afch/NixeTubesShieldNCS314/Firmware/Source code/Hardware Version 3.x (HW3.x)/NCS314_v3_SimpleSample/README.md

# Nixe Tubes Shield NCS314-4 v3.x and NCS314-6 v3.x code Example
Sketch for Arduino UNO/MEGA and Nixie Tubes Shield NCS314 and NCS312 by GRA &amp; AFCH

This very simple code shows the numbers 123456, and then after three seconds changes them to 654321. And so on an infinite number of times.
