afch/NixeTubesShieldNCS314/Firmware/Source code/Hardware Version 2.x (HW2.x)/60MinutesTimer/Readme.txt

Mode button - Start/Pause
Up button - Set to 60 minutes
Down button - Set to 00:00:00

IR Remote controller Sony RM-X151:

"Left" = Up button
"Enter" = Mode button
"Right" = Down button
