afch/NixeTubesShieldNCS314/Schemes/Scheme_Nixie_Clock_Shield_NCS314_v1.2.pdf

Hour | Hour
Min | Min | Sec LAMP1 | LAMP2 | Sec

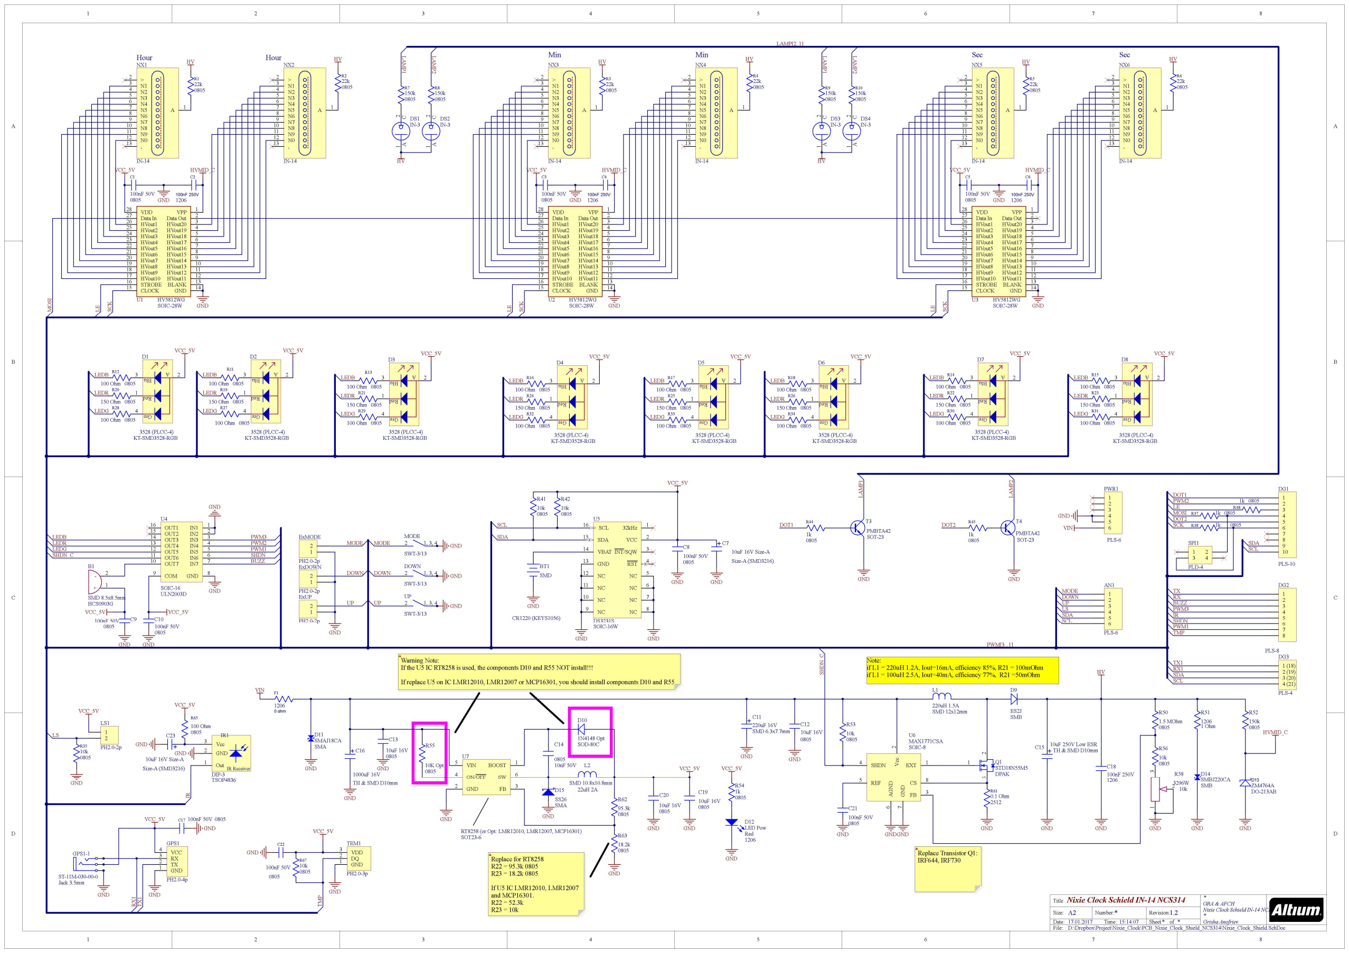
[picture p1: page 1]

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
GRA & AFCH
Nixie Clock Schield IN-14 NCS314 *
* | Grisha Anofriev

## Nixie Clock Schield IN-14 NCS314

* | 1.2
17.01.2017 15:14:07
D:\Dropbox\Project\Nixie_Clock\PCB_Nixie_Clock_Shield_NCS314\Nixie_Clock_Shield.SchDoc

Title

Size: | Number:
Date:
File:

Revision:
Time: | Sheet | of

A2

IN-3 1 2 A CDS2

IN-3 1 2 A CDS1

150k
0805

R8
150k
0805
R7 LAMP1 | LAMP2

LEDR

LEDG

IN-3 1 2 A CDS4

IN-3 1 2 A CDS3

150k
0805

R10
150k
0805

R9

100 Ohm 0805

R12

150 Ohm 0805

R20

100 Ohm 0805

R28

VCC_5V

LEDR

LEDG

100 Ohm 0805

R16

100 Ohm 0805

R32

LEDR

LEDG

100 Ohm 0805

R13

150 Ohm 0805

R21

100 Ohm 0805

R29

LEDR

LEDG

100 Ohm 0805

R18

100 Ohm 0805

R34

LEDR

LEDG

100 Ohm 0805

R17

100 Ohm 0805

R33

LEDR

LEDG

100 Ohm 0805

R15

150 Ohm 0805

R23

100 Ohm 0805

R31

LEDR

LEDG

100 Ohm 0805

R14

150 Ohm 0805

R22

100 Ohm 0805

R30

LEDR

LEDG

LEDB | LEDB LEDB | LEDB | LEDB LEDB LEDB | LEDB
100 Ohm 0805

R11

LED Pow
Red
1206

D12

1k
0805

R54

GND

GND | VCC_5V

95.3k
0805

R62

18.2k
0805

R63

GND

10nF 50V

0805

C14

GND

SS26
SMA

D15

GND

GND

10uF 16V
0805

C13

GND

GND

SOIC-8

SHDN 4

REF 5 | AGND

### 6 GND

7

FB | 3
CS | 8
EXT | 1 Vcc 2

MAX1771CSA

U6 10k
0805

R53

GNDGND

100nF 50V
0805

C21

GND

GND

220uH 1.5A
SMD 12x12mm

L1

ES2J
SMB

D9

100nF 250V
1206

C18

GND | GND

### 1.5 MOhm

0805

R50

10k
0805

R56

GND | GND

10uF 16V
0805

C12

GND

HVMID_C

1206

### 1 Ohm

R51

GND SHDN_C | HV

3296W

10k ³ 1

2

R58

GND

GND

150k
0805

R52

SMBJ220CA
SMB
1000uF 16V | D14
TH & SMD D10mm

C16

10uF 250V Low ESR
TH & SMD D10mm C15

10uF 16V
0805

C20
10uF 16V
0805

C19

10K Opt
0805

R55

SMD 10.8x10.8mm
22uH 2A

L2

1N4148 Opt
SOD-80C

D10

FB | 3
VIN 5 | BOOST | 1

GND 2

SW 6 ON/OFF 4

RT8258 (or Opt: LMR12010, LMR12007, MCP16301) SOT23-6

U7

### Note: if L1 = 220uH 1.2A, Iout=16mA, efficiency 85%, R21 = 100mOhm if L1 = 100uH 2.5A, Iout=40mA, efficiency 77%, R21 =50mOhm

SOIC-16
ULN2003D
IN1 | 1
IN2 | 2
IN3 | 3
IN4 | 4
IN5 | 5
IN6 | 6
IN7 | 7

OUT1 16

OUT3 14
OUT4 13
OUT5 12
OUT6 11
OUT7 10

OUT2 15

COM 9 | GND | 8

U4

SMD

CR1220 (KEYS1056)

BT1

10k
0805

R41
10k
0805

R42

100nF 50V
0805

C8

100nF 50V
0805

C10 100nF 50V
0805

C9

VCC_5V

GND | GND

GND

GND | GND
VCC_5V | VCC_5V

PWM3
PWM2
PWM1
SHDN
BUZZ

SHDN_C

LEDB
LEDR
LEDG

SCL

SDA

10uF 16V Size-A
Size-A (SMD3216)

C7

GND

GND

SMD 8.5x8.5mm
HCS0903G

+

1

2

B1

2 1, 3, 4

SWT-3/13

MODE

2 1, 3, 4

SWT-3/13

DOWN

2 1, 3, 4

SWT-3/13

UP

GND

GND

GND

MODE

DOWN

UP

HV5812WG
SOIC-28W
VPP | 1
Data Out | 2
HVout20 | 3
HVout19 | 4
HVout18 | 5
HVout17 | 6
HVout16 | 7
HVout15 | 8
HVout14 | 9
HVout13 | 10
HVout12 | 11
HVout11 | 12
BLANK | 13
GND | 14 CLOCK 15 | STROBE 16 | HVout10 17 | HVout9 18 | HVout8 19 | HVout7 20 | HVout6 21 | HVout5 22 | HVout4 23 | HVout3 24

VDD 28
Data In 27
HVout1 26
HVout2 25

U1

22k
0805
R1 | 22k
| 0805

R2

100nF 250V
1206

C2

HV | HV

100nF 50V
0805

C1

GND

VCC_5V | HVMID_C

GND

HV5812WG
SOIC-28W
VPP | 1
Data Out | 2
HVout20 | 3
HVout19 | 4
HVout18 | 5
HVout17 | 6
HVout16 | 7
HVout15 | 8
HVout14 | 9
HVout13 | 10
HVout12 | 11
HVout11 | 12
BLANK | 13
GND | 14 CLOCK 15 | STROBE 16 | HVout10 17 | HVout9 18 | HVout8 19 | HVout7 20 | HVout6 21 | HVout5 22 | HVout4 23 | HVout3 24

VDD 28
Data In 27
HVout1 26
HVout2 25

U2

22k
0805
R3 | 22k
| 0805

R4

100nF 250V
1206

C4

HV | HV

100nF 50V
0805

C3

GND

VCC_5V | HVMID_C

GND

HV5812WG
SOIC-28W
VPP | 1
Data Out | 2
HVout20 | 3
HVout19 | 4
HVout18 | 5
HVout17 | 6
HVout16 | 7
HVout15 | 8
HVout14 | 9
HVout13 | 10
HVout12 | 11
HVout11 | 12
BLANK | 13
GND | 14 CLOCK 15 | STROBE 16 | HVout10 17 | HVout9 18 | HVout8 19 | HVout7 20 | HVout6 21 | HVout5 22 | HVout4 23 | HVout3 24

VDD 28
Data In 27
HVout1 26
HVout2 25

U3

22k
0805
R5 | 22k
| 0805

R6

100nF 250V
1206

C6

HV | HV

100nF 50V
0805

C5

GND

VCC_5V | HVMID_C

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
PLS-6

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
PLS-10

DG1

PWM2

MOSI

SCK

MODE
DOWN
UP
LS
SDA
SCL

BUZZ
PWM3

SHDN

VIN

VIN

GND MOSI | LE | SCK
R37 | 1k 0805

PWM1

LE

1k 0805

R48 LE | SCK | LE | SCK
R38 | 1k | 0805

DOT1

1k
0805
R44 | LAMP¹

GND

DOT1
1k
0805
R45 | LAMP²

GND

DOT2

LAMP[2..1]

PWM[3...1]

>

2
N1 3
N2 4
N3 5
N4 6
N5 7
N6 8
N7 9
N8 10
N9 11
N0 12

A

1

,

13

IN-14

NX1

>

2
N1 3
N2 4
N3 5
N4 6
N5 7
N6 8
N7 9
N8 10
N9 11
N0 12

A

1

,

13

IN-14

NX2

>

2
N1 3
N2 4
N3 5
N4 6
N5 7
N6 8
N7 9
N8 10
N9 11
N0 12

A

1

,

13

IN-14

NX3

>

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

A

1

,

13

IN-14

NX4

>

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

A

1

,

13

IN-14

NX5

>

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

A

1

,

13

IN-14

NX6

PLS-6

1
2
3
4
5
6

PWR1

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
PLS-8

DG2

150 Ohm 0805

R26

150 Ohm 0805

R25

150 Ohm 0805

R24
150 Ohm 0805

R19

100 Ohm 0805

R27

SOT-23

PMBTA42

T3

SOT-23

PMBTA42

T4

VCC_5V

100nF 50V
0805

C22

GND | GND

GND

GND

GND

VCC_5V

VCC_5V

10uF 16V Size-A
Size-A (SMD3216)

C23

100 Ohm
0805
R65 RX¹ TX¹ | TMP IR

TX
RX

IR

10k
0805

R67

Out 1

GND 2

Vcc 3

DIP-3
TSOP4836

IR Receiver

IR1

DOT2

VCC_5V

PLD-4

1 2
3 4

SPI1

3528 (PLCC-4)

2

1

KT-SMD3528-RGB

3

4 | Red Blu Gre | A

D1

VCC_5V

3528 (PLCC-4)

2

1

KT-SMD3528-RGB

3

4 | Red Blu Gre | A
D2 | VCC_5V

3528 (PLCC-4)

2

1

KT-SMD3528-RGB

3

4 | Red Blu Gre | A
D3 | VCC_5V

3528 (PLCC-4)

2

1

KT-SMD3528-RGB

3

4 | Red Blu Gre | A

D4

VCC_5V

3528 (PLCC-4)

2

1

KT-SMD3528-RGB

3

4 | Red Blu Gre | A

D5

VCC_5V

3528 (PLCC-4)

2

1

KT-SMD3528-RGB

3

4 | Red Blu Gre | A

D6

VCC_5V

3528 (PLCC-4)

2

1

KT-SMD3528-RGB

3

4 | Red Blu Gre | A

D7

VCC_5V

3528 (PLCC-4)

2

1

KT-SMD3528-RGB

3

4 | Red Blu Gre | A

D8

PH2.0-2p

1

2

ExMODE

PH2.0-2p

1

2

ExUP

PH2.0-2p

1

2

ExDOWN

GND

MODE

DOWN

UP

HV | HV

SCL

SDA

TMP

GND

PH2.0-2p

1
2

LS1

10k
0805

R35

VCC_5V

LS

TX1
RX1
SDA
SCL

1 (18)
2 (19)
3 (20)
4 (21)
PLS-4

DG3

220uF 16V
SMD 6.3x7.7mm

C11

### 0.1 Ohm

2512

R61

STD18N55M5

DPAK ²
1 3

Q1

ZM4764A
DO-213AB

D13

SMAJ18CA
SMA

D11

1206

### 0 ohm

F1

ST-11M-030-00-0
Jack 3.5mm

GPS1-1

GND

GND 1

TX 2

RX 3

VCC 4

PH2.0-4p

GPS1

GND 1

DQ 2

VDD 3

PH2.0-3p

TEM1

32kHz | 1
VCC | 2
INT/SQW | 3
RST | 4 GND 13

VBAT 14

SDA 15

SCL 16

NC | 5
NC | 6
NC | 7
NC | 8 NC 9

NC 10

NC 11

NC 12

DS3231S
SOIC-16W

U5

GND | GND

C17 100nF 50V 0805
GND

### Replace for RT8258

R22 = 95.3k 0805
R23 = 18.2k 0805

### If U5 IC LMR12010, LMR12007

and MCP16301.
R22 = 52.3k
R23 = 10k

### Warning Note: If the U5 IC RT8258 is used, the components D10 and R55 NOT install!!!

If replace U5 on IC LMR12010, LMR12007 or MCP16301, you should install components D10 and R55

### Replace Transistor Q1: IRF644, IRF730
