afch/NixeTubesShieldNCS314/User Manual/1.82/Render_poster_6px_2.png

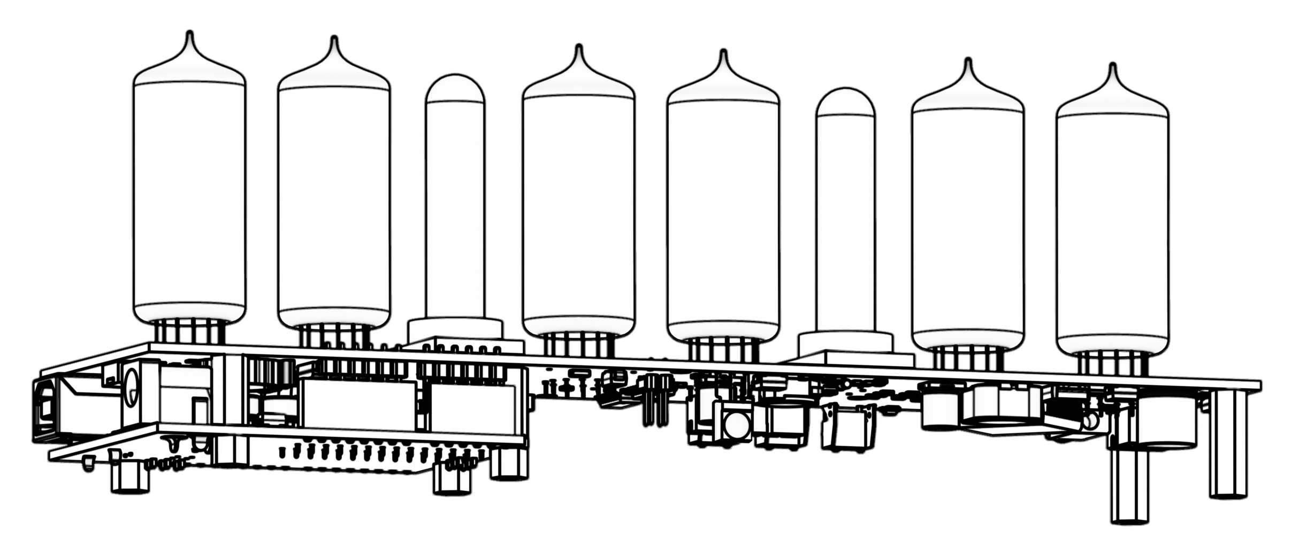
User Manual/1.82/Render_poster_6px_2.png
