afch/NixeTubesShieldNCS314/User Manual/1.82/User Manual Nixie Clock Shield NCS3xx.pdf

# GRA & AFCH

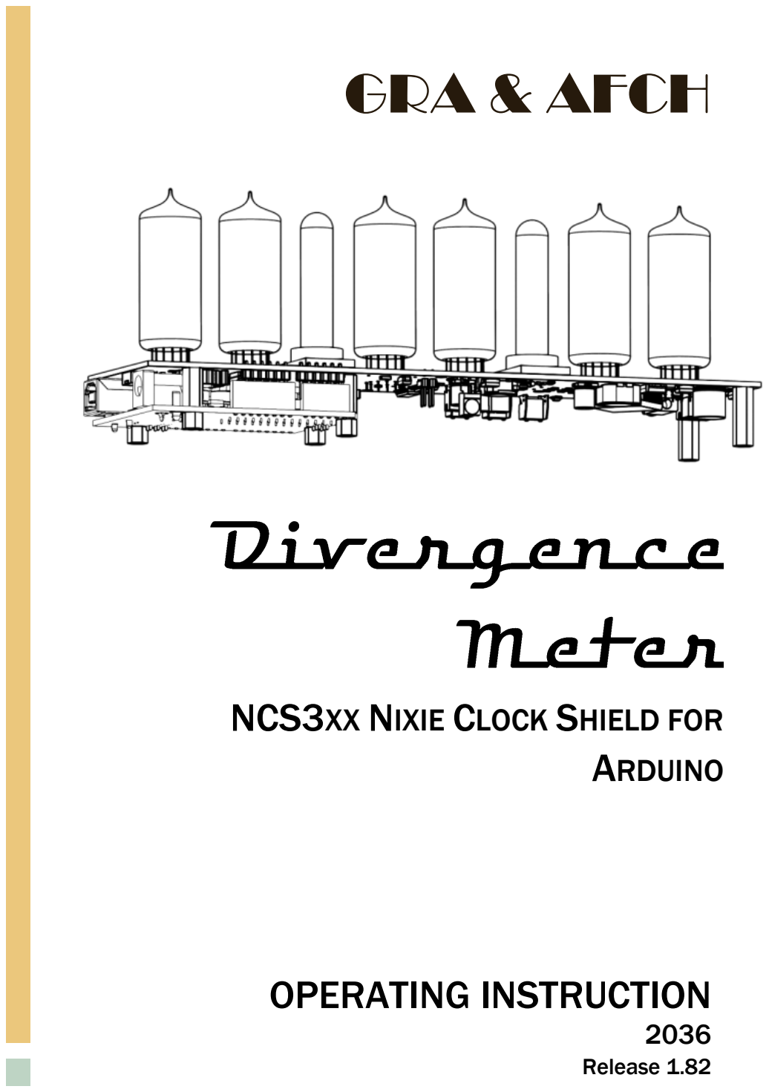
[picture p8: page 1]

# NCS3XX NIXIE CLOCK SHIELD FOR

# ARDUINO

# OPERATING INSTRUCTION

2036

### Release 1.82

GENERAL GU IDE

1. Pr es s “M ode” to ch ang e fr om m ode to m ode . Ea ch m ode is e xpl ain ed in deta il on t he fo ll ow ing pa ges .

TIMEK EEPIN G MODE

T o s e t th e di git al t im e

1. Hol d down “M ode” wh il e in th e Tim e k eepi ng Mo de unt il th e ho ur s digit s s tar t t o flas h . Th e h our s flas h b ec au s e the y are s el ected .
2. Pr es s “Mod e” t o ch ang e th e s el ec ti o n in th e fo ll ow ing s e que nc e:
- Onc e y ou r e ac h th e T im ek e epi ng dis play , y ou ha ve to ho ld d own “ Mo de ” agai n to d is pl ay fl as hi ng h our s .
- Whi le t he d igi ts ar e s el ect ed ( fl as h i ng) , h old d own “ Mo de” t o r e tur n to Tim ek e ep ing M ode w it hou t s av ing .
3. Whi le a ny d igi ts ar e s e le ct ed, pr es s “Up” to i ncr eas e the num ber , or “Down” t o de cr eas e the n um ber . H old ing do wn “Up” or “Dow n” cha nges t h e cur r en t s el ec ti on a t hig h s pee d.
4. After y ou s e t th e tim e , pr es s “M ode” to s e le ct t he T im ek e epi ng M ode .
- If you d o n ot op er at e any bu tt on f or a few m inut es whi le s e le ct io n is flas h ing, the f las h ing s t ops a nd th e cl ock g oes b ack t o th e T im ek e epi ng Mod e aut om at ic al ly.

DATE MODE

T o s e t th e da te

1. Hol d dow n “Mod e” whi le i n the Da te Mod e unt il th e al l dig its s tar t t o flas h .
2. Pr es s “Mod e” t o ch ang e s el ec ti on i n fol low ing s equ en ce:
- Whi le t he d igi ts ar e s el ect ed ( fl as h i ng) , h old d own “ Mo de” t o r e tur n to Tim ek e ep ing M ode w it hou t s av ing .
3. Pr es s “UP” or “Down” butto n to s witc h betw een dd/m m ( 31/ 12 /9 9) for m at an d m m /dd ( 12/ 3 1/9 9) for m at.
4. Whi le a ny d igi ts ar e s e le ct ed, pr es s “Up” to i ncr eas e the num ber , or “Down” t o de cr eas e the n um ber . H old ing do wn “Up” or “Dow n” cha nges t h e cur r en t s el ec ti on a t hig h s pee d.
5. After y ou s e t th e dat e, pr es s “M od e” to s e le ct t he Dat e M ode .
Time | Date | Alarm | 12/24 Time mode
Time Zone* | Temperature
Time | Date | Alarm

Time keeping mode

Days | Months
Date mode | Years

dd/mm or mm/dd
date format

- If yo u do n ot op er at e ant bu tt on f or a few m inutes wh il e a s el ec ti on i s flas h ing, t he fl as hi ng s to ps and c lo ck go es back t o the Da te M od e aut om ati ca ll y.
- The cl o ck d oes m ak e va lid at io n f or c or r ec t da te. S o cl o ck n ot t o r etur n to Date M od e if dat e is i nc or r ec t.

ALARM MODE

Whe n th e Dai ly Alar m Fun cti o n is s wi tch ed on, t he alar m s o unds a t th e pr es et t im e ea ch day. Pr es s an y butt on t o s top th e alar m after i t s tar ts to s ound .

T o s e t th e al ar m tim e

1. Hol d d own “M od e” wh ile in Alar m M o de un ti l th e h our di gits s tar t t o f las h . The h our d igi ts flas h b ec aus e t he y ar e sel ected .
2. Pr es s “Mod e” t o ch ang e s el ec ti on i n the f ol low ing s eq ue nce.
3. Pr es s “Up” or “Down” butto ns to in cr eas e or decr eas e s el ect ed dig its . Hol din g dow n but to ns cha nges the s e lec ti ons a t hig h s pe ed.
4. Dail y alar m on/ off m ode is r epr es e nti ng by upper s epar at e dots , pr es s “Up” or “Down” to e nab le or dis ab le dail y al ar m .
- Enter in g in A la rm Mode a lways sw itc h daily a larm on.
- I f you d o no t o pe rate a ny b ut tons a few m in ut es wh i le a se le ct ion i s flash ing , the f lash ing s to ps and the c loc k g oes t o the T im ek ee pin g Mod e.

12/24 Ho urs Mo de
T o cha nge 12/ 2 4 m od e
1. Enter i n 1 2/ 24 m ode s e tt ings , by h ol ding d own “ Mod e” bu tt on un ti l 1 2 o r 24 d igi ts s tar t t o flas h.
2. Pr es s “Up” or “Dow n” butt ons to s w it ch be twe en 1 2 and 24 m odes .
3. After y ou s et tim e for m at pr es s “Mo de” butt on t o r etur n to Tim ek eep in g m ode.
- I f you d o no t o pe rate a ny b ut tons a few m in ut es wh i le a se le ct ion i s flash ing , the f lash ing s to ps and the c loc k g oe s t o the T im ek ee pin g Mod e

Temperat ure Mode

T o cha nge t em per atur e for m a t Ce ls ius / Fa hr en he it or adjus t s h owi ngs of s e ns or

1. S ele ct T em per a tur e M od e, p r es s ing t he m od e but to n s ev er al t im es . ..
2. Enter in t em per a tur e m od e s ett ings , by ho ldi ng dow n “Mod e” butt on u nti l digi ts s tar t t o fl as h.
3. Pr es s “Up” or “Down” butt ons t o s wit ch bet wee n Cels ius and F ahr e nh ei t for m ats .
4. Pr es s “Mod e” but to n t o s av e s ett ings and r etur n to T em per a tur e m o de.
Hours | Minutes | Seconds
Timekeeping mode | Daily alarm on/off

Celsius / Fahrenheit
Temperature format

Adjustment
of temperature sensor

Temperature
Mode

# web-site: www.gra-afch.com

Time zone*

T o cha nge Time zone fr om -1 2 t o +1 4
1. S ele ct T im e zon e mode , pr es s in g the m ode but to n s ev er al tim es ( defau lt valu e is + 0 2) .
2. Pr es s “Up” to i ncr eas e t he n um ber , o r “Down” t o decr eas e the num ber .
- For n ega tiv e va lu es , th e t op ( or r ig ht ) dots is tur ned off.
3. Pr es s “Mod e” but to n t o s av e s ett ings and r etur n to T im e z one m ode .
* Tim e Z one M od e ava il abl e on ly with Ar d uin o M ega, a nd it is us ed tog eth er wit h an e x t er na l GPS r ecei v er GA-6.

RGB LED Backlight
T o d is ab le LED b ack lig ht
1. Hol d dow n “Dow n” unt il t he LED ba ck ligh t tur ns off.

T o e nab le LED b ack lig ht
1. Hol d dow n “Up” u nt il t he LED ba ck l ig ht tur ns on .

T o f ix c ol or o f LEDs
1. Pr es s “Down” bu tt on .

T o r es um e au tom a ti c LEDs c ol or c han gin g
1. Pr es “Up” butt on .

POWER ON SELF TEST

Im m edi ate ly aft er a cl ock is p ower e d on S elf- Tes t is s tar t ing in t he fo ll o wing s eque nc e:

1. Red LEDs o n.
2. Gr een LEDs on.
3. Blu e LEDs o n.
4. Tubes t es t w hi ch dis pla y al l dig its fr o m 0 to 9 on a ll tub es s im ul tan eo us ly .
5. Fir m war e ver s i on .
6. S ound t es t.
