afch/NixeTubesShieldNCS314/User Manual/1.82/[Originals]/Render_WO_IR_White_6px.JPG

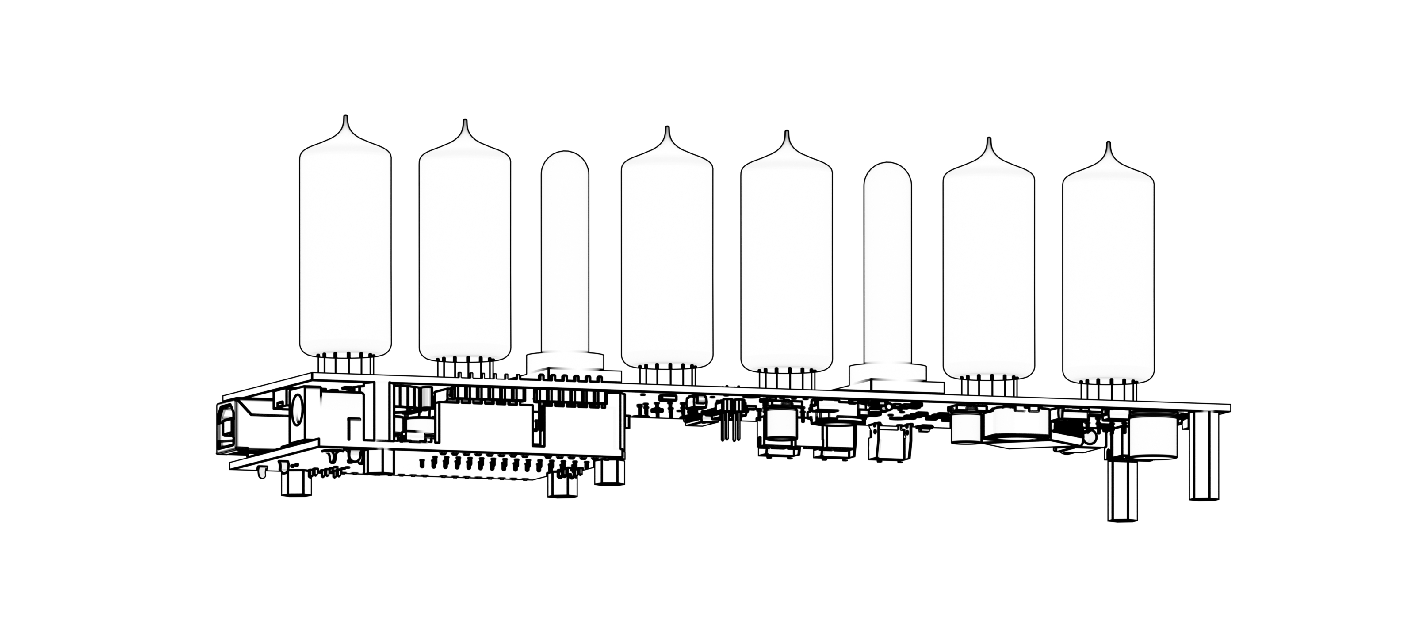
User Manual/1.82/[Originals]/Render_WO_IR_White_6px.JPG
