afch/NixeTubesShieldNCS314/User Manual/1.82/Render_White_6px.JPG

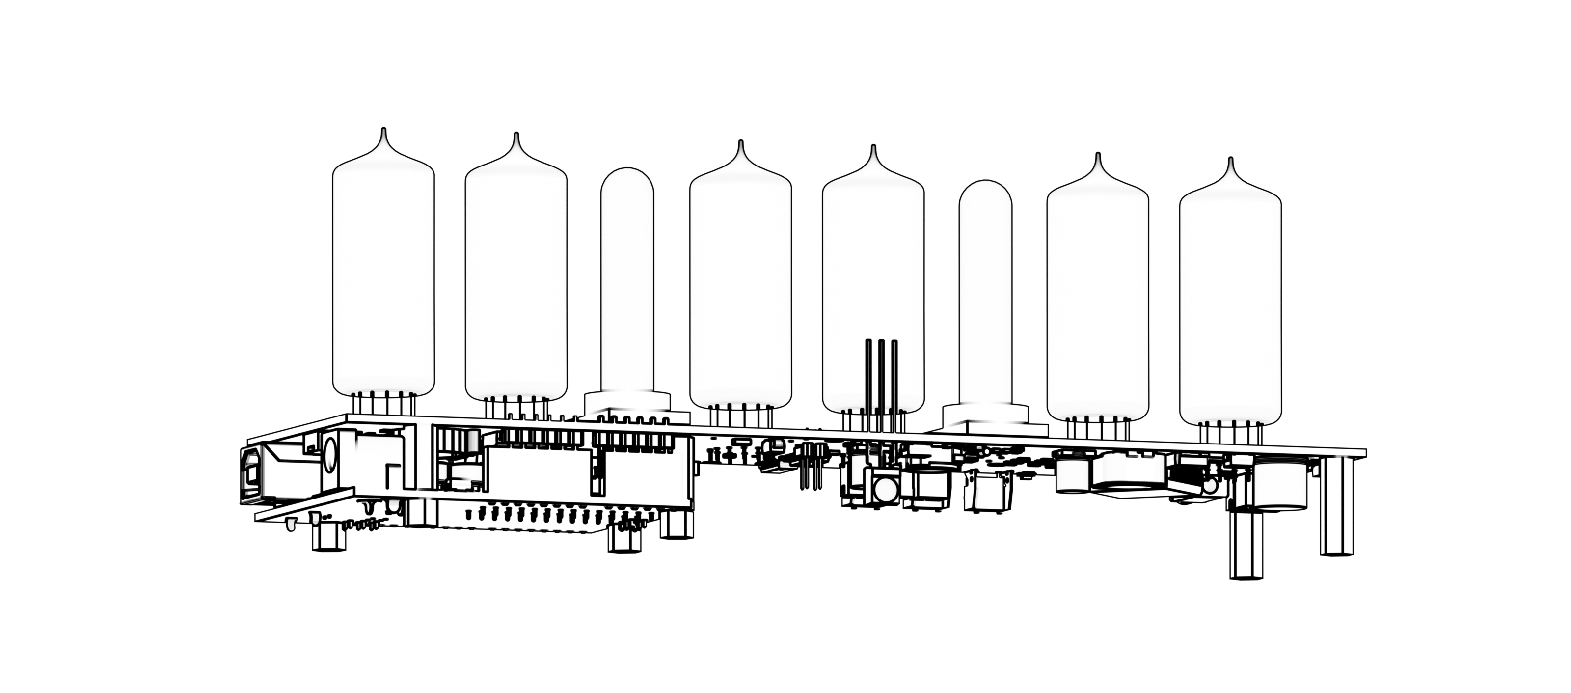
User Manual/1.82/Render_White_6px.JPG
