afch/NixeTubesShieldNCS314/(threads)

Thread 3 (2017-11-19):

Any plans to support Serial Slave Operation?

gilgameshskytrooper, 2017-11-19:
So I know currently you guys don't support Slave via Serial USB, but do you have any plans to add this in the future? ([like this](https://github.com/afch/Slave-Nixie-Clock)

afch, 2017-11-20:
We did not plan to do this in the near future.
But we are sure that it will not be difficult at all to transfer this functional from the old version.
In addition, we have an experimental adapter for connecting our watches to the RaspberryPI.
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

gubagu, 2017-11-21:
Why not to esp8266 instead of raspberry? RPI is such an overkill for a clock. Though it could be a bit of a hassle if you the project uses a low to pwm pins. esp8266 has only one analog pin ...

gilgameshskytrooper, 2017-11-21:
True, but essentially in already using a Pi for the alarm functionality for [my project](https://hackaday.io/project/15048-prometheus-alarm-clock). So I thought I might as well try to utilize NTP to control the nixie displays as well.

Thread 6 (2018-02-17):

Troubleshooting guide?

rcreasey, 2018-02-17:
I just got done with a marathon of soldering only to plug it in and not have any response from the shield.

Are there typical things to check or debug?

afch, 2018-02-21:
Typical problem is in power adapter.
Check voltage at test points:
TP1 - must be 12-15 Volts
TP3 - must be 5 Volts
TP4 - must be 170-190 Volts

2018-02-17 23:34 GMT+02:00 Ryan C. Creasey <notifications@github.com>:

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

--
Alexey [GRA & AFCH]

rcreasey, 2018-02-21:
Ah, you're right.  The voltage is low on those touch points.  Is the USB power draw on the arduino mega not sufficient to power the shield?  Will I need the power adapter for the mega?

afch, 2018-02-21:
Yes, it will work only with external power adapter 12-15 Volts, 1 (or more)
Ampere.

21 февр. 2018 г. 6:42 ПП пользователь "Ryan C. Creasey" <
notifications@github.com> написал:

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

rcreasey, 2018-02-24:
Hrm, I've got a 12V/1A power adapter and I'm seeing the following:

TP1 - 2v
TP3 - 2.1v
TP4 - 2.1v

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

rcreasey, 2018-02-25:
I should also note that I'm able to see the serial logs for the display test and on the first bootup with re-flashing the .ino, I did "hear" the musical theme play (albeit very quietly).

Subsequent unplugs have not re-prompted the musical tune however.

Serial logs show that the menu buttons are indeed working.

afch, 2018-03-01:
Sorry for delay with answer.
With good quality 12 Volts adapter, you must get about 11.2 Volts on TP1!!!
I think than You need to replace your adapter.

2018-02-25 2:25 GMT+02:00 Ryan C. Creasey <notifications@github.com>:

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

--
Alexey [GRA & AFCH]

Thread 7 (2018-02-28):

LS1 Connector

edgarasf123, 2018-02-28:
Is there a reason for LS1 connector? I noticed its connected to A3(analog input) but its not being used in any way within the firmware.

afch, 2018-03-01:
Now it is not used at all, we planned to connect an ambient light sensor,
but changed our minds.

2018-02-28 12:42 GMT+02:00 H3xCat <notifications@github.com>:

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

--
Alexey [GRA & AFCH]

edgarasf123, 2018-03-01:
I see, thank you for response.

judge2005, 2018-03-02:
I forked the repo a while back and implemented dimming using an LDR, plus a bunch of other stuff such as cross-fading, date display, date formats, etc. Plus control via an ESP01 connected as an I2C master. Code is in https://github.com/judge2005/NixeTubesShieldNCS314, specifically https://github.com/judge2005/NixeTubesShieldNCS314/blob/master/NixieClockShieldNCS314HW1.1.ino.

Code for ESP01 is in https://github.com/judge2005/NCS314WiFi

edgarasf123, 2018-03-17:
I'm in the process of creating my own firmware, though its only for HW2.0 cause that is what I got. So far I was able to write GPS support(auto baud detection), DST, and Nixie library. It currently only shows time retrieved from GPS, so without GPS it won't show anything. I'm going to be implementing RTC next.

https://github.com/edgarasf123/NixieClockFW

Closed 2018-03-01.

Thread 9 (2018-04-06):

Red LED color doesn't save on shutdown

wiilover22, 2018-04-06:
Simple little bug, with hopefully a quick fix. When you turn off the clock (by unplugging it or otherwise), if the last color used is red, it'l start back up on a blue/purple color next startup.

afch, 2018-04-09:
Thank you, you really found a bug...

2018-04-07 1:33 GMT+03:00 wiilover22 <notifications@github.com>:

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

--
Alexey [GRA & AFCH]

afch, 2018-12-13:
Fixed

Closed 2018-12-13.

Thread 12 (2018-10-31):

error

stilloading, 2018-10-31:
i get this
avrdude.exe: stk500_recv(): programmer is not responding
avrdude.exe: stk500_getsync() attempt 1 of 10: not in sync: resp=0xa4
avrdude.exe: stk500_recv(): programmer is not responding
avrdude.exe: stk500_getsync() attempt 2 of 10: not in sync: resp=0xa4
avrdude.exe: stk500_recv(): programmer is not responding
avrdude.exe: stk500_getsync() attempt 3 of 10: not in sync: resp=0xa4
avrdude.exe: stk500_recv(): programmer is not responding
avrdude.exe: stk500_getsync() attempt 4 of 10: not in sync: resp=0xa4
avrdude.exe: stk500_recv(): programmer is not responding
avrdude.exe: stk500_getsync() attempt 5 of 10: not in sync: resp=0xa4
avrdude.exe: stk500_recv(): programmer is not responding
avrdude.exe: stk500_getsync() attempt 6 of 10: not in sync: resp=0xa4
avrdude.exe: stk500_recv(): programmer is not responding
avrdude.exe: stk500_getsync() attempt 7 of 10: not in sync: resp=0xa4
avrdude.exe: stk500_recv(): programmer is not responding
avrdude.exe: stk500_getsync() attempt 8 of 10: not in sync: resp=0xa4
avrdude.exe: stk500_recv(): programmer is not responding
avrdude.exe: stk500_getsync() attempt 9 of 10: not in sync: resp=0xa4
avrdude.exe: stk500_recv(): programmer is not responding
avrdude.exe: stk500_getsync() attempt 10 of 10: not in sync: resp=0xa4

avrdude.exe done.  Thank you.

what to do ?
i am using arduino uno,

stilloading, 2018-11-01:
i only have one port to chose from, and i have this arduino
https://www.ebay.com/itm/263884202082
does the other type of arduino work differently ?

afch, 2018-11-06:
> i only have one port to chose from, and i have this arduino
> https://www.ebay.com/itm/263884202082
> and on the internet it says there is no difference in this arduino borad compared to others.
try to install this driver: https://gra-afch.com/drivers/CH340g_Windows_Drivers.zip

stilloading, 2018-11-06:
i still get same problem
avrdude: Version 6.3-20171130
         Copyright (c) 2000-2005 Brian Dean, http://www.bdmicro.com/
         Copyright (c) 2007-2014 Joerg Wunsch

         System wide configuration file is "C:\Program Files (x86)\Arduino\hardware\tools\avr/etc/avrdude.conf"

         Using Port                    : COM3
         Using Programmer              : arduino
         Overriding Baud Rate          : 115200
avrdude: stk500_recv(): programmer is not responding
avrdude: stk500_getsync() attempt 1 of 10: not in sync: resp=0x6c
avrdude: stk500_recv(): programmer is not responding
avrdude: stk500_getsync() attempt 2 of 10: not in sync: resp=0x6c
avrdude: stk500_recv(): programmer is not responding
avrdude: stk500_getsync() attempt 3 of 10: not in sync: resp=0x6c
avrdude: stk500_recv(): programmer is not responding
avrdude: stk500_getsync() attempt 4 of 10: not in sync: resp=0x6c
avrdude: stk500_recv(): programmer is not responding
avrdude: stk500_getsync() attempt 5 of 10: not in sync: resp=0x6c
avrdude: stk500_recv(): programmer is not responding
avrdude: stk500_getsync() attempt 6 of 10: not in sync: resp=0x6c
avrdude: stk500_recv(): programmer is not responding
avrdude: stk500_getsync() attempt 7 of 10: not in sync: resp=0x6c
avrdude: stk500_recv(): programmer is not responding
avrdude: stk500_getsync() attempt 8 of 10: not in sync: resp=0x6c
avrdude: stk500_recv(): programmer is not responding
avrdude: stk500_getsync() attempt 9 of 10: not in sync: resp=0x6c
avrdude: stk500_recv(): programmer is not responding
avrdude: stk500_getsync() attempt 10 of 10: not in sync: resp=0x6c

avrdude done.  Thank you.

Problem uploading to board.  See http://www.arduino.cc/en/Guide/Troubleshooting#upload for suggestions.

stilloading, 2018-11-25:
i foubd out its the firmware on the arduino that is faulty because it is cheap, i fixed it by following this video
https://www.youtube.com/watch?v=90GZ7WhvubM
But now i have the problem that it suddenly stops and plasshes as seen here in the end of the video (i also had problems with the RGB LED,s but that was just bad soldering on my part)
https://www.youtube.com/watch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

Thread 13 (2018-12-12):

HW2.2 scheme missing

Adrian-at-CrimsonAuzre, 2018-12-12:
Like the title says, circuit diagrams are missing for the new version of the clock.

Would it be possible to upload the 3D models of the clocks as well? It would be nice to have to design 3D printed cases for the clock.

edgarasf123, 2018-12-12:
I thought the circuit is basically the same as HW2.0, except it comes with sockets.

edgarasf123, 2018-12-12:
Regarding 3D models, cases specifically, I asked the authors if they could provide the files for laser cutting ourselfs. They said they didn't have access to those files, since third-party is manufacturing the cases.

Regardless, I managed to replicate the case in Fusion 360 and laser cut them. I got the buttons a bit off though, used Dremel to fix it.
https://a360.co/2C6ZKcT

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

afch, 2018-12-13:
Scheme v2.2. now available on github:
https://github.com/afch/NixeTubesShieldNCS314/blob/master/Schemes/Scheme_Nixie_Clock_Shield_NCS314_v2.2.pdf

ср, 12 дек. 2018 г. в 07:59, H3xCat <notifications@github.com>:

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

--
Alexey [GRA & AFCH]

Closed 2018-12-13.

Thread 14 (2019-02-13):

how to deactivate slot machine effect

Gauner101184, 2019-02-13:
Hi,

i want to deactivate slot machine effect and showing date.
Which lines i have to change in source code for disabling these features?
I only want to show actual time without any effects.

edgarasf123, 2019-02-14:
I wouldn't recommend this, as it would drastically decrease the lifetime of your nixie tubes.

afch, 2019-02-14:
If You still want this, You need to find and comment the string like this:
if ((menuPosition == TimeIndex) || (modeChangedByUser == false) ) modesChanger();

Gauner101184, 2019-02-15:
> If You still want this, You need to find and comment the string like this:
> if ((menuPosition == TimeIndex) || (modeChangedByUser == false) ) modesChanger();

Thanks for your answer.
But that's the actual code.
What i have to change?

z0ne123, 2020-01-13:
> If You still want this, You need to find and comment the string like this:
> if ((menuPosition == TimeIndex) || (modeChangedByUser == false) ) modesChanger();

Is it also possible to leave in the slotmachine effect for anti-poisoning and disable everything else. So the clock only displays time and every once in a while does a slotmachine effect. Thanks

afch, 2020-01-14:
Yes, it is possible.
You can have only SlotMachine without Date and Temp display.

пн, 13 янв. 2020 г. в 16:07, z0ne123 <notifications@github.com>:

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

--
Alexey [GRA & AFCH]

z0ne123, 2020-01-14:
> Yes, it is possible.

Can you elaborate how? I can't figure out how to do it in the regular settings, I have some basic programming skills, but I don't know what edits I have to do to get this to work!

I commented this line at the moment :
// if ((menuPosition == TimeIndex) || (modeChangedByUser == false) ) modesChanger();

But this disables all except the time, slotmachine is disabled as well now.

afch, 2020-01-16:
Hello.

Please use attached screenshot from Debug window as reference.
Comment highlighted portions as shown.
And add line of code that is underlined at bottom of screenshot.
That should omit the showing of date and temperature readings from
SlotMachine routine.

If there will be questions, feel free to ask.
Regards.

вт, 14 янв. 2020 г. в 14:34, z0ne123 <notifications@github.com>:

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

--
Alexey [GRA & AFCH]

Thread 17 (2020-10-07):

Is it possible to turn the bulbs off in software?

SapientHetero, 2020-10-07:
I'd like to integrate a PIR sensor with a NCS314 V2.2 in order to extend bulb life by turning them off when nobody is in the room to see them. Is there any way to do this in software?

afch, 2020-10-08:
Hello.

We have a Hardware pinout and logic on the Board for the PIR sensor.
However we did not implemented its usage in the Software (Firmware).
One of our buyers have implemented several similar functions in our
Firmware as a mods.
Please use link below to his blog and ask him for code and other info:
https://www.buildxyz.xyz/nixieclock-build-guide/

This blog should be useful to you.
Write back if there will be any other questions.

Regards.

ср, 7 окт. 2020 г. в 17:30, Sapient Hetero <notifications@github.com>:

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

--
Alexey [GRA & AFCH]

h3xcat, 2020-10-09:
https://github.com/afch/NixeTubesShieldNCS314/blob/master/Firmware/Source%20code/Hardware%20Version%202.0%20(HW2.0)/NixieClockShield_NCS314/doIndication314_HW2.x.ino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

https://github.com/afch/NixeTubesShieldNCS314/blob/master/Firmware/Source%20code/Hardware%20Version%202.0%20(HW2.0)/NixieClockShield_NCS314/doIndication314_HW2.x.ino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

Delorean14, 2021-01-21:
https://github.com/afch/NixeTubesShieldNCS314/blob/adb9bca8aa63063cb1de16f8eab42e1fc1e984dd/Firmware/Source%20code/Hardware%20Version%202.0%20(HW2.0)/NixieClockShiel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

Write this variable LOW and they shut off.

regorwislon, 2023-02-21:
Can you shed more light (information) on the logic / pinout for a PIR sensor on the NCS314 board (I have v3.4) that you refer to.  I note from the board schematic that pin D8 is not used by the shield and potentially could be used to connect a PIR sensor. I was thinking of using this to set BL (SHDN) on pin D5 “LOW” when the sensor did not detect any motion for a period, which would turn off the high voltage to all of the tubes, but there is probably a more elegant way of accomplishing this. The link you suggested to another customer didn’t really help me with this as much as I had hoped.

SapientHetero, 2023-02-21:
I ended up switching from the PIR sensor to an ultrasonic sensor: https://www.amazon.com/HiLetgo-HC-SR04-Ultrasonic-Distance-MEGA2560/dp/B00E87VXH0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 because the PIR sensor kept detecting the airflow from air conditioning vents in the ceiling and no filter algorithm I tried could reject it well enough while still sensing human presence. These aren’t perfect either but they’re better than the PIR sensors.

```
// Proximity Sensor – note that it also needs power and ground
#define TRIGGER_PIN  23   // Arduino pin tied to trigger pin on the ultrasonic sensor.
#define ECHO_PIN     25   // Arduino pin tied to echo pin on the ultrasonic sensor.
NewPing sonar(TRIGGER_PIN, ECHO_PIN, MAX_DISTANCE); // NewPing setup of pins and maximum distance.
```

Here's the code I use with the sensor

`// ***** Handle Peeking - detect/extend/end peek mode

  // Starting peek mode in response to ultrasonic sensor
  // If object is detected within configured distance while bulbs are off (sleeping), turn bulbs on in dimmed mode (set elsewhere) for the configured period of time.
  // If daytime, leave them on as long as object is detected
  if (sleeping) {

    if (Settings.alarmBulbsOnDuration && alarmRinging) {               // if configured to do so...
      if (!peekStart)                                                  //  and not already peeking...
        peekStart = millis();                                          //  enter Peek mode on alarm...
      peekDuration = Settings.alarmBulbsOnDuration;                    //  for the configured period of time.
      sleeping = false;                                                //  turn sleeping off when alarm sounds so bulbs turn on
      dimming = false;                                                 //  turn off dimming so PWM doesn't distort alarm music
      RGBLedsOn = Settings.RGBLedsOn;                                  //  and restore RGB LEDs to previous setting
      //DEBUG_PRINTLN(F("Entering peek mode due to alarm"));
    }

    // while waiting for peeking to end, just disable sleeping
    if (peekStart > 0 && (millis() - peekStart < (uint32_t)peekDuration * 1000UL)) { // leave bulbs on if in peek mode...
      sleeping = false;
    }

    // check for sonar ping indicating peeking should start or be extended
    if (millis() - lastSonarPingTime > SONAR_READ_INTERVAL &&                // only do pings at specified interval...
        !ESPTransactionInProgress) {                                         //  and NOT when a transaction is in progress or Serial3 data will be lost
      lastSonarPingTime = millis();                                          // don't ping too often or processor becomes sluggish
      uint16_t maxDistance = (uint16_t)Settings.dayPeekDistance;             // if not dimming, activate sonar at max distance
      if (dimming)                                                           // at night, activate only when sensor is triggered at configured distance
        maxDistance = Settings.peekDistance;
      if (alarmRinging)
        maxDistance = Settings.peekDistance;                        // if alarm is ringing, turn it off if hand is waved in front of sensor
      maxDistance = maxDistance*2 + maxDistance/2;                           // convert maxDistance to cm from inches, roughly
      uint32_t distance = sonar.ping_in(maxDistance);                        // do a ping
      if (distance > 0 && distance <= maxDistance) {                         // if distance is zero, there was no detection, otherwise...
        if (alarmRinging) {                                                  //  if alarm is ringing...
          alarmRinging = false;                                              //   turn it off...
          song = parseSong(noSong);                                          //   and stop playing song
        } else if (!peekStart)
          peekDuration = Settings.peekDuration;                              // determines how long peek will last
        peekStart = millis();                                                // indicates peek cycle in progress and tells us when to end it if it's night time
        sleeping = false;                                                    // turn off sleeping so time is displayed
      }
    }
  }

  // ending peek mode
  if (peekStart > 0) {
    if (millis() - peekStart > (uint32_t)peekDuration * 1000UL) {            // turn peek mode off after configured time elapses
      DEBUG_PRINTLN(F("Leaving peek mode"));
      peekStart = 0;
    }
  }

`

regorwislon, 2023-02-22:
Thank you. I'll try and get my head around that. I still haven't figured out the best way to actually turn the tubes off / on.

regorwislon, 2023-02-22:
I'm thinking of using LEpin as suggested above, and only allowing it to go HIGH if recent motion has been detected. Is that too simple?

regorwislon, 2023-02-22:
It was too simple! Setting LEpin LOW only stops the tubes from changing from what they are already displaying. However my original idea of using BL (the Blanking pin) by setting pinSHDN  LOW does turn them off, and restoring pinSHDN to HIGH turns them back on again. 🙂

SapientHetero, 2023-02-22:
Glad you got it working.

You can also dim the bulbs by using pulse width modulation on LEpin.

// these values determine how dim the bulbs are when dimming is enabled. Lower pulse width + lower delay = dimmer bulbs

uint8_t dimPulseWidth[4] = {15, 30, 45, 65};

uint32_t dimDelay[4] = {500, 1000, 1500, 2000}; // in microseconds; this matters more than pulsewidth

Then insteading of setting LEpin high to display the time, set it to your desired pulse width

if (dimming) {

delayMicroseconds(dimDelay[Settings.dimmingSetting-1]);

analogWrite(LEpin, dimPulseWidth[Settings.dimmingSetting-1]);

}

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

regorwislon, 2023-02-22:
Many thanks for your help and for sharing your knowledge and work. much appreciated.

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

SapientHetero, 2023-02-23:
By the way,  I am using a combination Mega/ESP8266 board to control my Nixie Clock [[https://www.amazon.com/gp/product/B07THDDFSJ/ref=ppx_yo_dt_b_search_asin_title?ie=UTF8&psc=1](url). Instead of using the non-user-friendly buttons on the back of the clock to change settings, I run a webserver on the ESP8266 and control it via WiFi.

regorwislon, 2023-02-23:
Nice idea. I have played around with the ESP32Cam board which also runs a webserver to monitor the camera so I might explore this combined board when I have a bit of time. Still have to build a case for my clock.

Thread 18 (2020-11-13):

Option > blinking, static or off columns/colons in time mode?

Gittegatt, 2020-11-13:
Hello afch,
I like the clock very much. I would really appreciate it, if you could add the option to deactivate still blinking columns/colons in time mode to have the choice about blinking, static or off columns/colons. If you don't like and reject the proposal, could anyone please let me know how to change the code to get static or off columns/colons? Or would you do not recommend to fire the columns/colons bulbs all the time in general?

Regards,
Gittegatt.

afch, 2020-11-16:
Hello Gittegatt.

We do not recommend in general to turn ON the Columns for all the time.
However there is a possibility to turn OFF the Dots by changing the code in
the Firmware.
If you will be able to change the code in the Firmware we can provide the
code segment for you.
Please write back to us.

Regards.

пт, 13 нояб. 2020 г. в 19:44, Gittegatt <notifications@github.com>:

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

--
Alexey [GRA & AFCH]

Gittegatt, 2020-11-18:
Hello afch,
yes - provisioning of the part of code in time mode would be great! Thanks.

Regards.

Gittegatt, 2021-02-03:
Any ideas?

Regards.

h3xcat, 2021-02-04:
You can try modifying my firmware which should be a bit easier. Though my firmware was written NCS314 HW2.0 specifically and can't guarantee compatibility with any other hardware versions.

In your case, you can omit the following block and it would turn the columns into static.
https://github.com/h3xcat/nixie-clock-fw/blob/master/NixieClockFW/NixieClockFW.ino#L104-L109

Closed 2023-05-24.

Thread 19 (2020-11-17):

IR Remote No longer Working on Firmware Version 1.9

SlashWade, 2020-11-17:
Hi, I upgraded the firmware to version 1.9 and the IR Remote is no longer working. Is anyone else having this issue?

afch, 2020-11-17:
Hello Asad.

Please provide the version of your Shield Board.
And also the Firmware version for us.
And we will be able to provide help.

Regards.

вт, 17 нояб. 2020 г. в 02:36, Asad <notifications@github.com>:

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

--
Alexey [GRA & AFCH]

SlashWade, 2020-11-17:
Thank you, I have the NCS314 V2.2, previously used Firmware version 1.86 and everything worked but now I'm using 1.9 with minor modifications shown here: https://github.com/SlashWade/nixie/tree/testingSIlence.

Did I mess up the code?

afch, 2020-11-18:
Hello Asad.

It seems like you could have used the file for another Shield Board version.
Please double check the file again, it should be for the Board ver 2.2, not
for 3.4.
Write back if you will need help.

Regards.

вт, 17 нояб. 2020 г. в 21:19, Asad <notifications@github.com>:

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

--
Alexey [GRA & AFCH]

SlashWade, 2020-12-05:
Hi, yes the firmware is for the correct board version. I uploaded your original 1.90 firmware (https://github.com/afch/NixeTubesShieldNCS314/tree/master/Firmware/Source%20code/Hardware%20Version%202.0%20(HW2.0)/NixieClockShield_NCS314) and the IR still did not work.

I only made minor changes to this file (https://github.com/SlashWade/nixie/blob/testingSIlence/NixieClockShield_NCS314/NixieClockShield_NCS314.ino) and the IR stopped working.

The old version 1.86 firmware used to work perfectly, can I have a link to that? Thanks.

GRA-AFCH, 2020-12-07:
Hello Asad.

The previous Firmware version is available on our GitHub channel: 'afch'.
Feel free to use it, meanwhile we will look into the issue and check the
latest Firmware for issues regarding the Remote.

Regards.

вс, 6 дек. 2020 г., 01:47 Asad <notifications@github.com>:

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

Thread 21 (2021-01-16):

Slot machine effect does not work correctly with connected temperature sensor

Uhwah, 2021-01-16:
My Clock is a NCS314-6 v3.3
When I connected the temperature sensor, the slot machine effect does not work properly.  The display sometimes jumps to the next value and back again before the slot machine effect is over.  It doesn't look very nice optically.  Tested with Arduino UNO and Mega.  as soon as I remove the sensor everything works fine.

If you are interested, I can provide a video.

Thread 23 (2021-04-01):

IR not working for UNO or MEGA 1.94

bobsalt, 2021-04-01:
I can't get IR receiver to work. I've tried compiled hex and ino compile, on UNO and MEGA boards.
I see where someone had same issue, and said the 1.86 version works, but I can't find that version anywhere.

any update on this?

edit:
using remote that works on older in-12 clock (assuming same remote IR codes?)
Firmware version: 1.940
NCS314 for HW 2.x

bobsalt, 2021-04-06:
It was the remote, I found a rm-x153 and can get mode, up and down to work with it.
The power doesn't do anything though and that was my goal.
sorry and thanks!
bobsalt

afch, 2021-04-06:
Hello.

Great, if you will need more help, feel free to write back.

Regards.

вт, 6 апр. 2021 г. в 03:08, bobsalt ***@***.***>:

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

--
Alexey [GRA & AFCH]

Closed 2021-04-06.

Thread 24 (2021-04-15):

Firmware for NCS312 v1.5?

zen85, 2021-04-15:
Hello!

I just got the NCS312 v1.5 and i tried severall firmwares for it since there is none dedicated to v1.5. But they show the wrong values. I tried with a mega and with an uno. the behaviour is the same. iE when i use the following code:
`
//NIXIE CLOCK SHIELD NCS314 v 2.x by GRA & AFCH (fominalec@gmail.com)
//1 26.06.2018
//Simple code for HV5122PJ-G Hihg Voltage registers

#include <SPI.h>

const byte LEpin=10; //pin Latch Enabled data accepted while HI level

String stringToDisplay="000000";// Conten of this string will be displayed on tubes (must be 6 chars length)

//                            0      1      2      3      4      5      6      7      8       9
unsigned int SymbolArray[10]={1,     2,     4,     8,     16,    32,    64,    128,   256,    512};

/*******************************************************************************************************
Init Programm
*******************************************************************************************************/
void setup()
{

  Serial.begin(115200);
  Serial.println(F("Starting"));

  pinMode(LEpin, OUTPUT);

 // SPI setup
  SPI.begin(); //
  SPI.setDataMode (SPI_MODE2); // Mode 2 SPI
  SPI.setClockDivider(SPI_CLOCK_DIV8); // SCK = 16MHz/8= 2MHz

}

/***************************************************************************************************************
MAIN Programm
***************************************************************************************************************/
void loop() {
  stringToDisplay="123456";
  Serial.println(stringToDisplay);
  doIndication();
  delay(3000);
  stringToDisplay="222222";
  Serial.println(stringToDisplay);
  doIndication();
  delay(3000);
}

void doIndication()
{
  digitalWrite(LEpin, LOW);    // allow data input (Transparent mode)
  unsigned long Var32=0;

  long digits=stringToDisplay.toInt();

  //-------- REG 1 -----------------------------------------------
  Var32=0;

  Var32|=(unsigned long)(SymbolArray[digits%10])<<20; // s2
  digits=digits/10;

  Var32|=(unsigned long)(SymbolArray[digits%10])<<10; //s1
  digits=digits/10;

  Var32|=(unsigned long) (SymbolArray[digits%10]); //m2
  digits=digits/10;

  SPI.transfer(Var32>>24);
  SPI.transfer(Var32>>16);
  SPI.transfer(Var32>>8);
  SPI.transfer(Var32);

  //digitalWrite(LEpin, LOW);
 //-------------------------------------------------------------------------

 //-------- REG 0 -----------------------------------------------
  Var32=0;

  Var32|=(unsigned long)(SymbolArray[digits%10])<<20; // m1
  digits=digits/10;

  Var32|= (unsigned long)(SymbolArray[digits%10])<<10; //h2
  digits=digits/10;

  Var32|= (unsigned long)SymbolArray[digits%10]; //h1
  digits=digits/10;

  //digitalWrite(LEpin, HIGH);

  SPI.transfer(Var32>>24);
  SPI.transfer(Var32>>16);
  SPI.transfer(Var32>>8);
  SPI.transfer(Var32);

  digitalWrite(LEpin, HIGH);     // latching data
}

`

i get "999999" instead of "222222" and "89._t567" instead of "123456"

which firmware should i use?

esegege, 2021-06-04:
Hi, I have the same problem, do you solve it?

sdonogh, 2021-08-05:
I have the same issue

esegege, 2021-08-05:
I didnt found firmware for v 1.5, the developer said that the Firmware for this Model have merged with the NCS314 Repository.

grnbrg, 2021-12-02:
I received an NCS312 v1.5 (14/08/2020) pre-built shield today.  I was able to compile and flash an Arduino Mega with firmware based on the source at `NixeTubesShieldNCS314/Firmware/Source code/Hardware Version 2.0 (HW2.0)/`.

So it is possible.  I haven't had much of a chance to do much testing, but it appears to work as expected.  My only (minor) issue is that the buzzer is much louder than I'd like.  Hopefully I can find some way to make it quieter in software, or I may have to just desolder it from the board....

h3xcat, 2021-12-02:
Not all firmwares are compatible, as there are some that use different pin assignments and chip components. Schematics for NCS312V1 and NCS314V2 do appear to be identical. As long as they use the same pin assignments and components, I don't see any issues with swapping the firmware.

https://gra-afch.com/category/downloads/schemes/shields/

I found these schematics quite useful for converting my own custom firmware to NCS318 from NCS314.

grnbrg, 2021-12-02:
Yes, I spent a fair amount of time reviewing the schematics and examining the board before settling on the 314v2.0 source.  In the newer hardware versions, the two main tube drivers have been consolidated into a single large chip, so the 3.x tree was a non-starter.  The clock has been set, and is keeping time, the thermometer is reasonably accurate and the GPS time source is working.

I thought I'd report my success, as I am not the only one who was not entirely sure what code and/or firmware version to use on the latest hardware revision, since there is almost no mention anywhere of NCS312v1.5....  The short answer is that the NCS314v2.0 firmware (fw version 1.94) appears to work.  My plans are to eventually drive the shield with an ESP32, and add an FM radio module.  I expect to use the provided code more or less as a library to light the tubes based on my own code, in a DIY clock radio with all the features I've wanted, but never been able to find.  :)

Thread 28 (2024-03-08):

NCS314 HW3.4 all digits are glowing

forbidden-kiwi, 2024-03-08:
Based on your schematic drawing of your v3.4 shield I designed my own PCB for IN-8-2 tubes. Everything is working as expected except for the tubes an dots. All kathodes are are always on. Do you have any suggestions as to what it could be or which components I should check?
