afch/NixeTubesShieldNCS314/Schemes/Scheme_Nixie_Clock_Shield_NCS312_v1.5.pdf

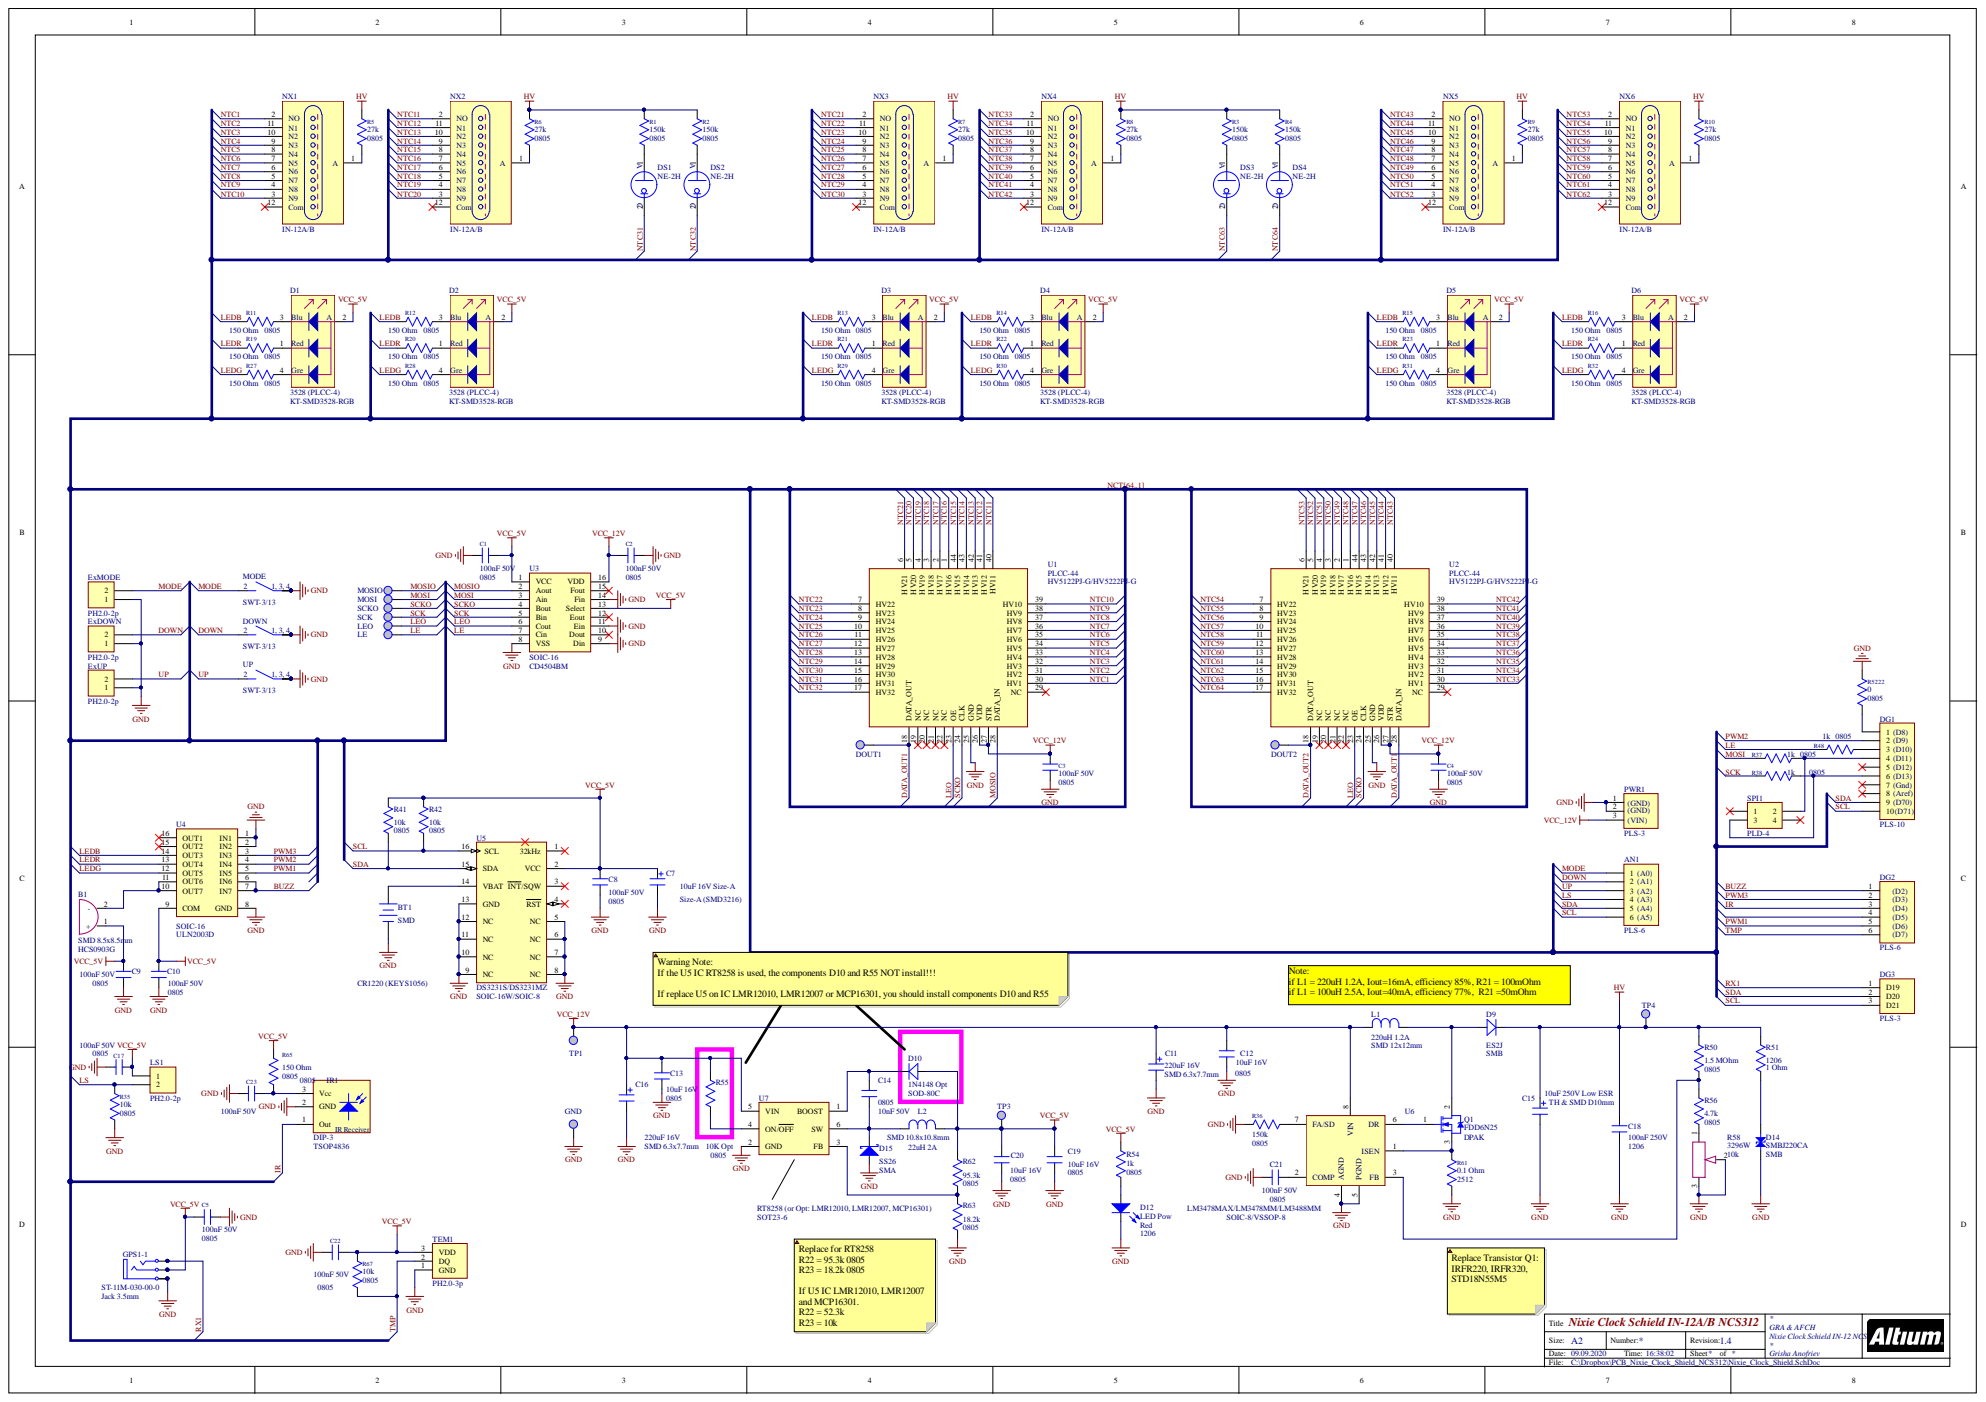
[picture p11: page 1]

LEDB | Blu | A | LEDB | Blu | A

Warning Note:
If the U5 IC RT8258 is used, the components D10 and R55 NOT install!!!

If replace U5 on IC LMR12010, LMR12007 or MCP16301, you should install components D10 and R55

Nixie Clock Schield IN-12A/B NCS312 Title | * GRA & AFCH Nixie Clock Schield IN-12 NCS312 * Grisha Anofriev

Size: A2 | Number: * | Revision: 1.4

Date: 09.09.2020 Time: 16:38:02 | | Sheet * of *
