afch/NixeTubesShieldNCS314/Schemes/Scheme_Nixie_Clock_Shield_NCS314-4_v3.0_B1.pdf

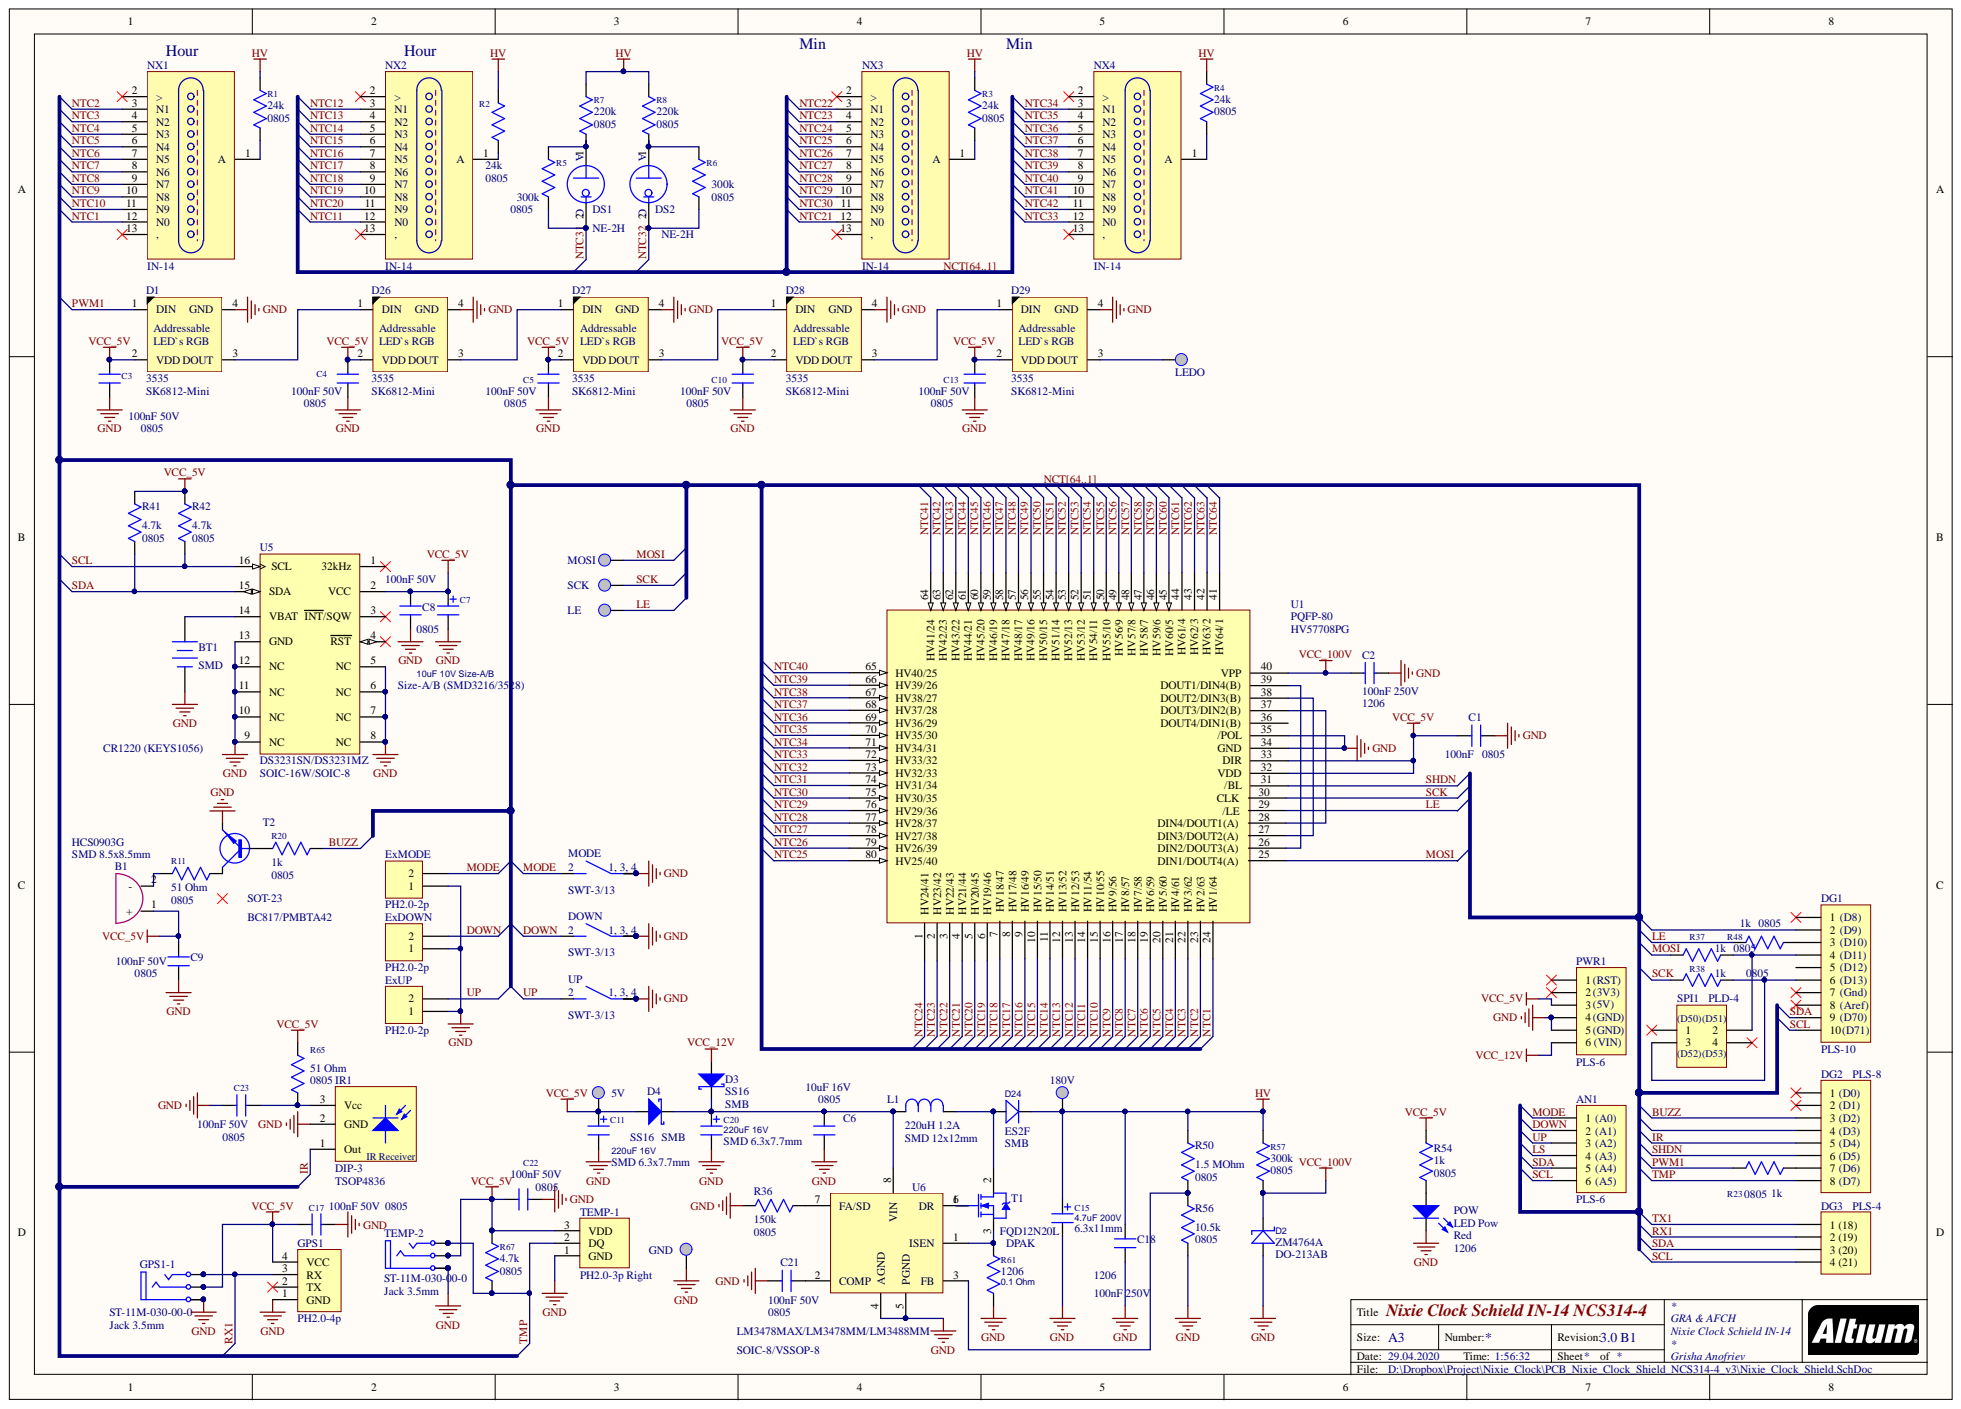
[picture p12: page 1]

SPI1 PLD-4
(D50)(D51) 1 2 3 4 (D52)(D53) | SDA

Nixie Clock Schield IN-14 NCS314-4
Title
