afch/NixeTubesShieldNCS314/Schemes/Scheme_Nixie_Clock_Shield_NCS314-6_2.3.pdf

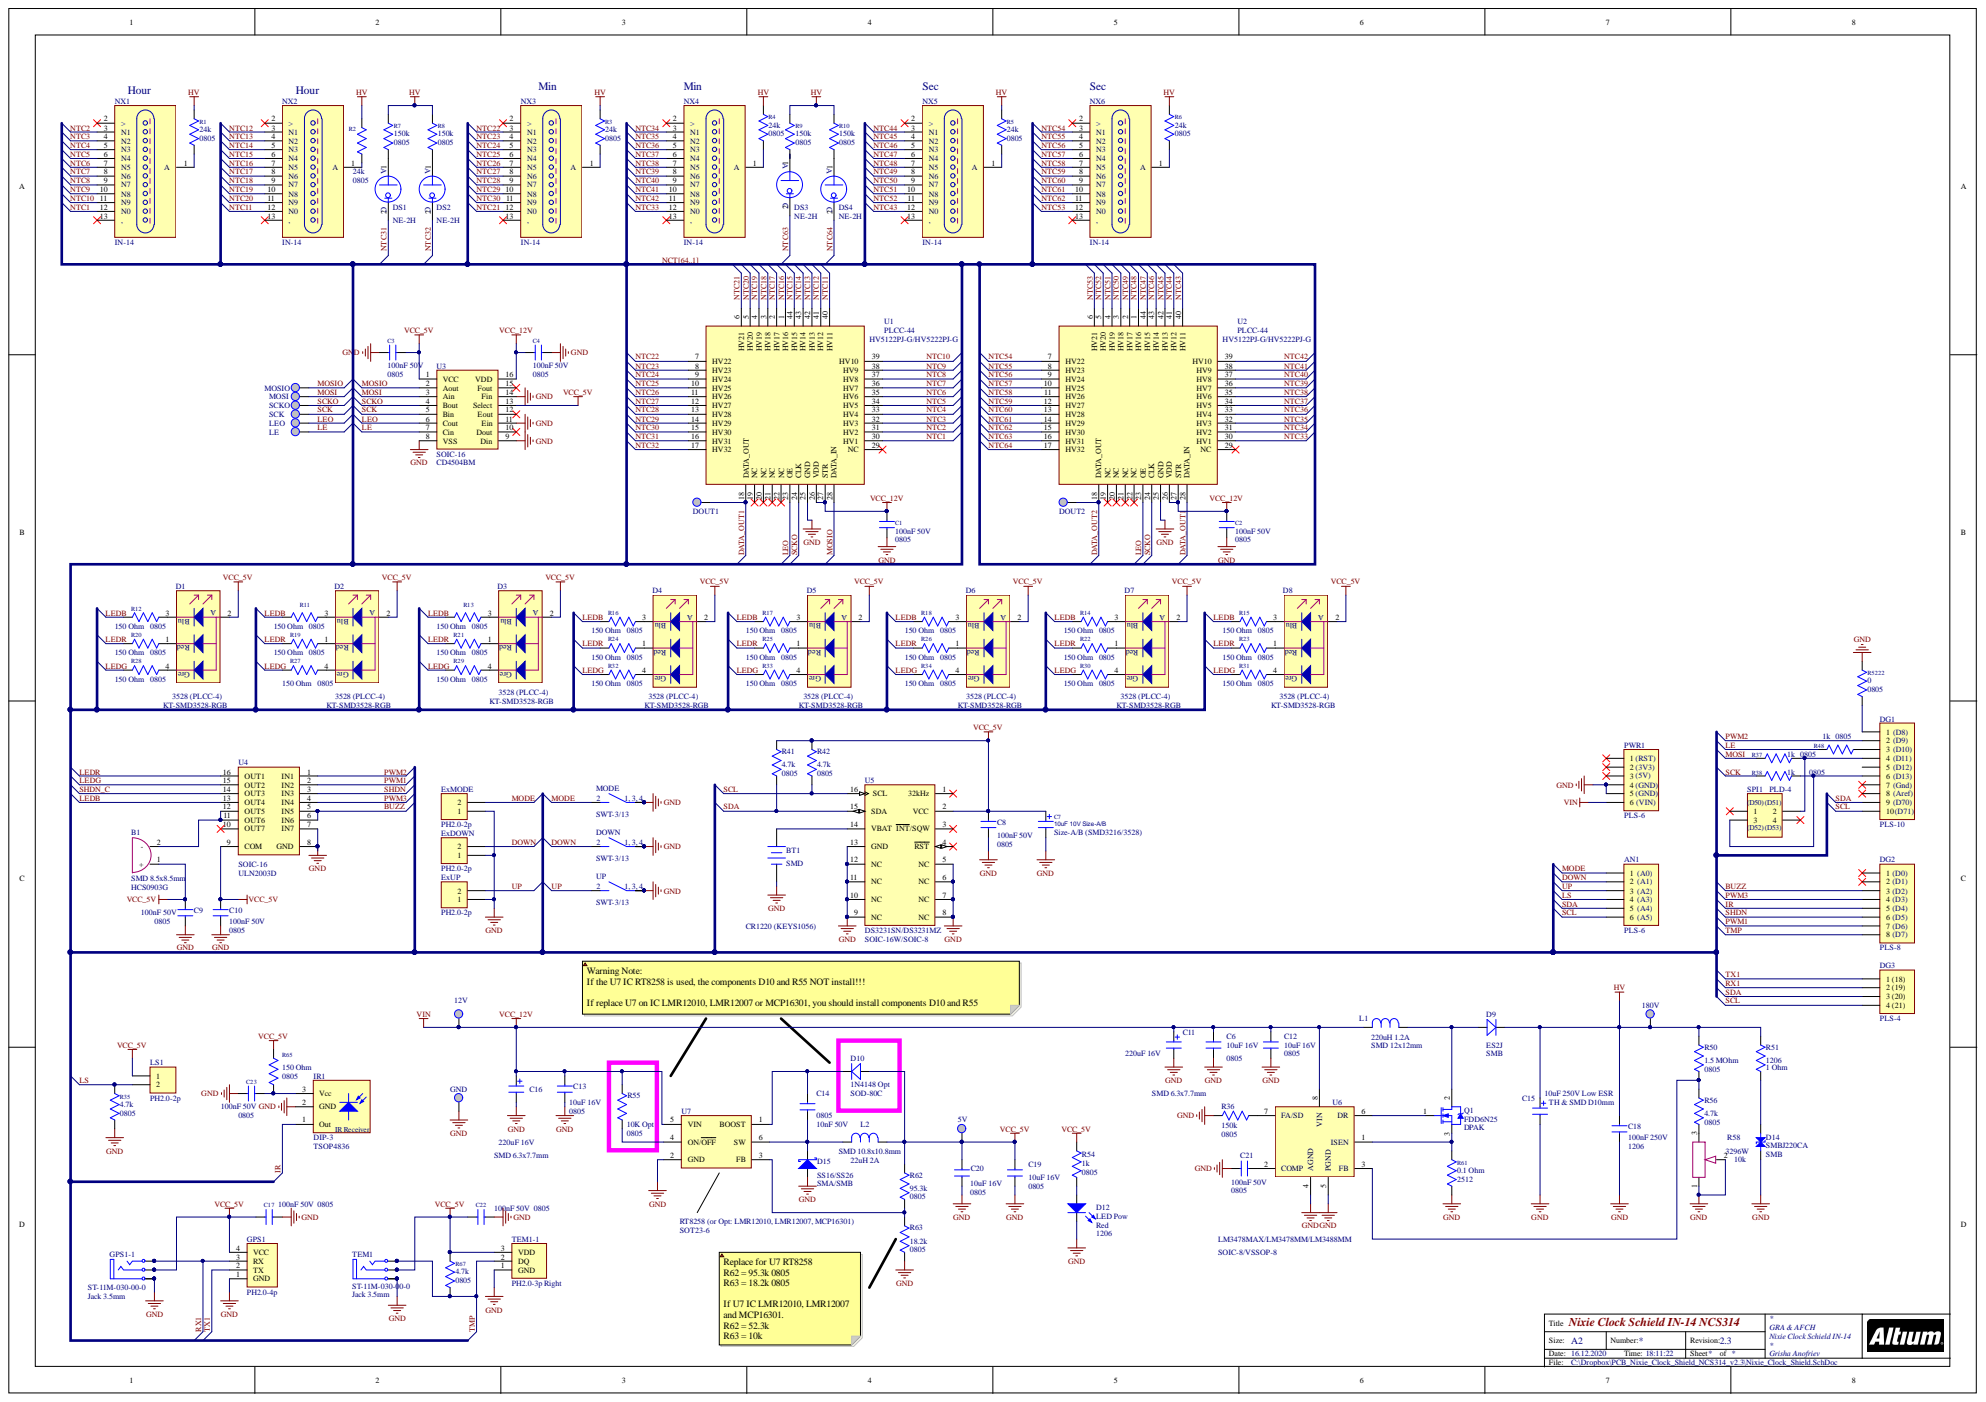
[picture p13: page 1]

Warning Note:
If the U7 IC RT8258 is used, the components D10 and R55 NOT install!!!

12V VIN VCC_5V VCC_5V R65

If replace U7 on IC LMR12010, LMR12007 or MCP16301, you should install components D10 and R55

D10 SOD-80C

Vcc 3

Nixie Clock Schield IN-14 NCS314 Title | * GRA & AFCH Nixie Clock Schield IN-14 * Grisha Anofriev

Size: A2 | Number: * | Revision: 2.3

Date: 16.12.2020 Time: 18:11:22 | | Sheet * of *
