afch/NixeTubesShieldNCS314/Schemes/Scheme_Nixie_Clock_Shield_NCS314_v2.0.pdf

Hour | Hour
Min | Min | Sec | Sec

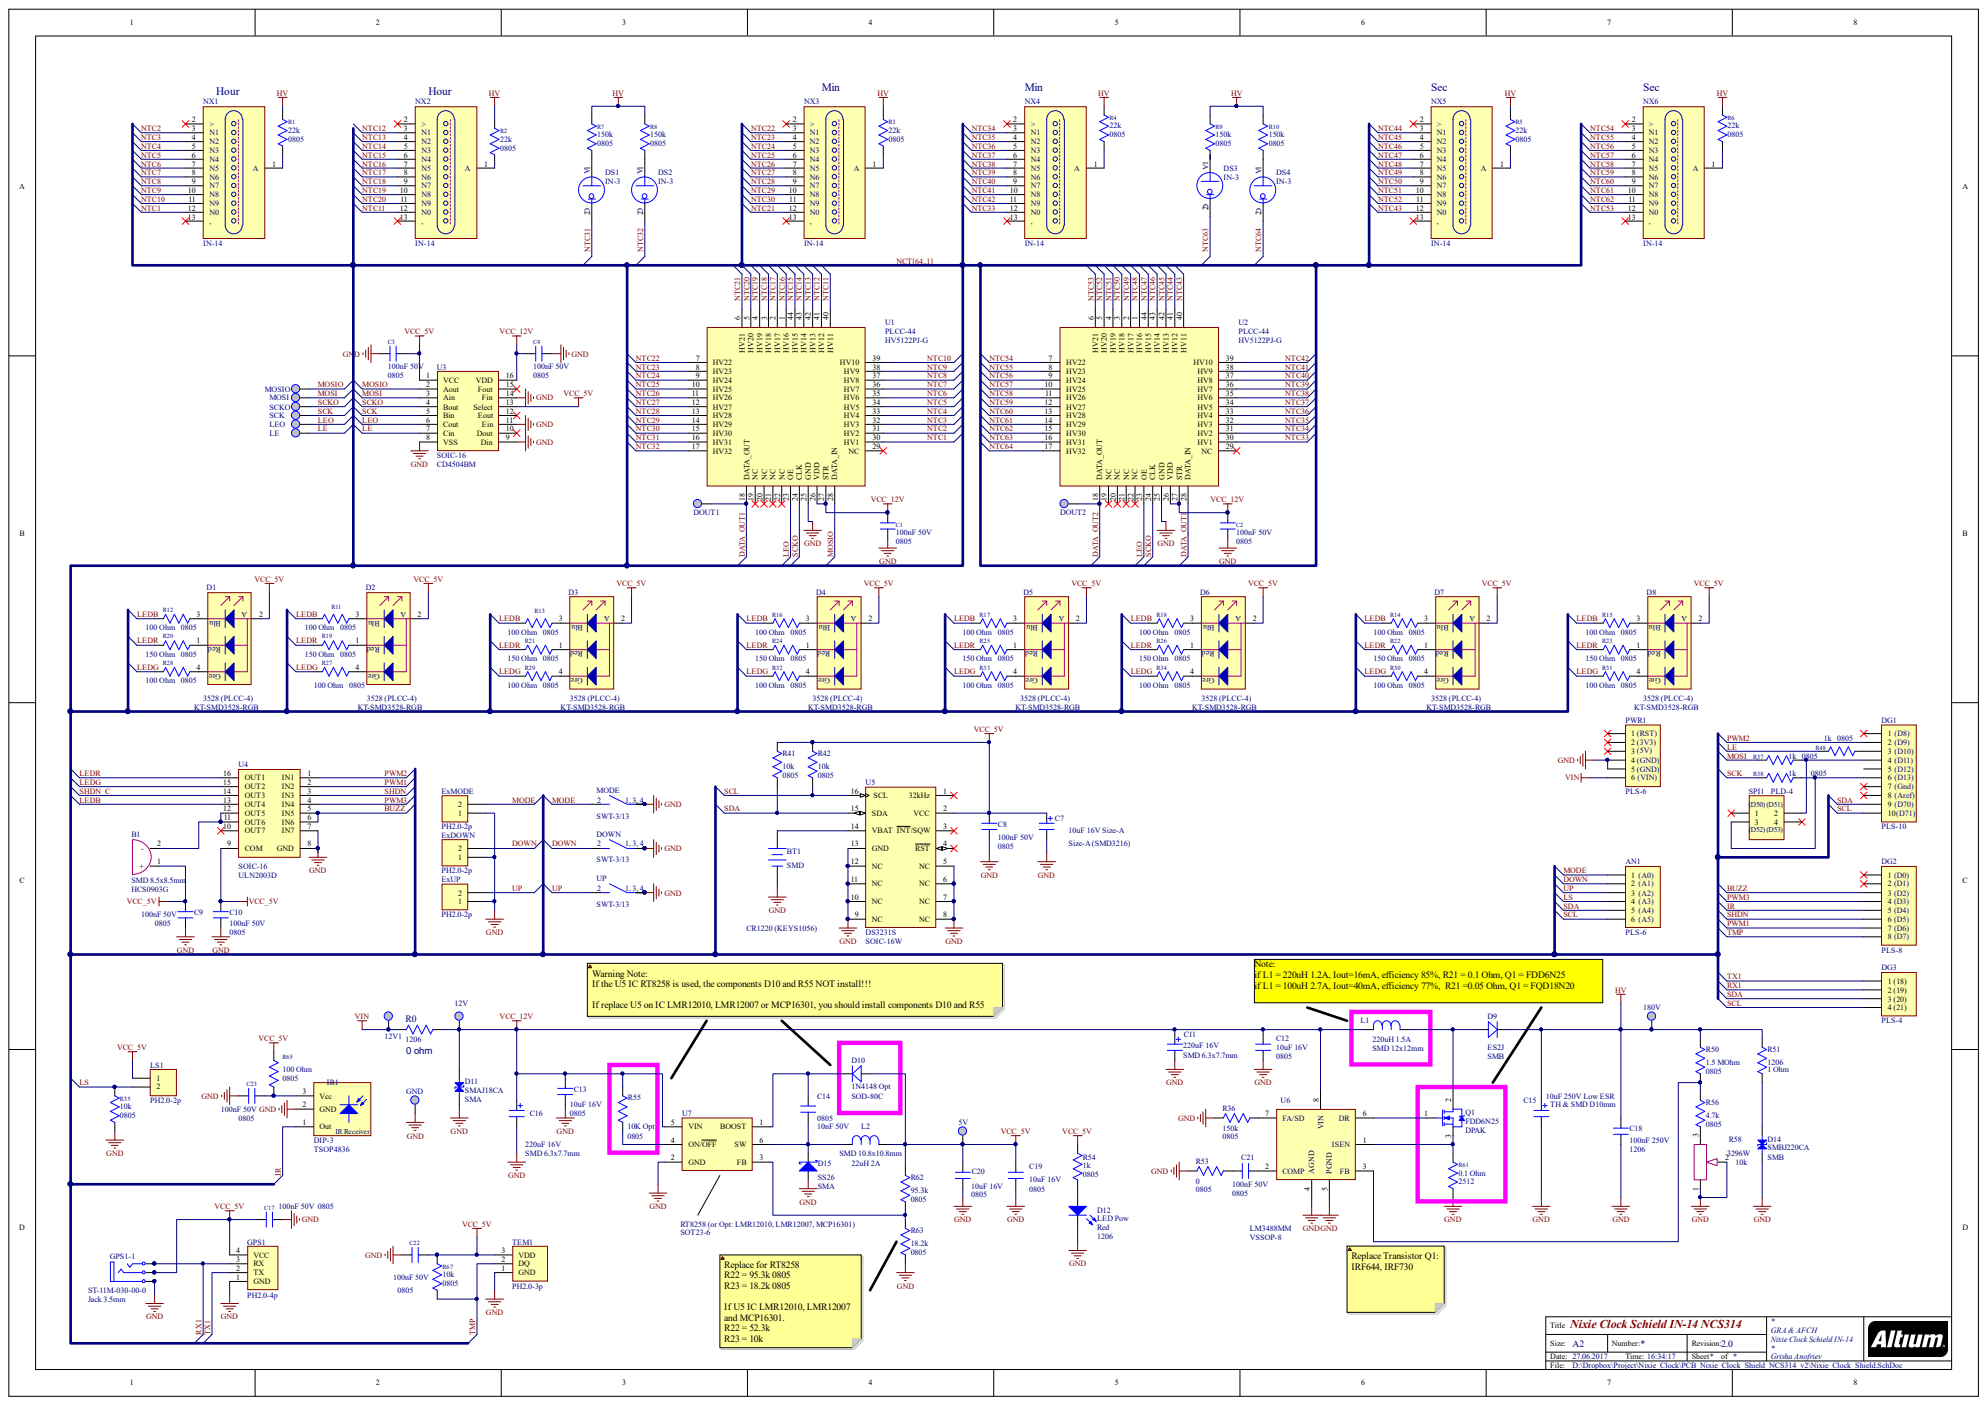
[picture p14: page 1]

Warning Note:
If the U5 IC RT8258 is used, the components D10 and R55 NOT install!!!

Note:
if L1 = 220uH 1.2A, Iout=16mA, efficiency 85%, R21 = 0.1 Ohm, Q1 = FDD6N25
if L1 = 100uH 2.7A, Iout=40mA, efficiency 77%, R21 =0.05 Ohm, Q1 = FQD18N20

If replace U5 on IC LMR12010, LMR12007 or MCP16301, you should install components D10 and R55

Nixie Clock Schield IN-14 NCS314
Title
