afch/NixeTubesShieldNCS314/(commit log)

2016-10-08 USB driver and flasher added
2016-10-18 ver 1.0.2
    Fixed: RGB color controls
    Update to Arduino IDE 1.6.12 (Time.h replaced to TimeLib.h)
2017-05-10 Antipoisoning slot machine effect
2017-07-24 v1.6
    Temperature mode added.
2017-08-06 Temperature, IR and GPS added
2017-11-17 v1.8 for Mega
    Temp. sensor, GPS and IR remote support added for Arduino Mega.
2018-02-08 Change arduino.h include to Arduino.h to make it work with Sketch on Linux as well
2018-07-07 Fix typo in directory name
    [NCS314SimpleSampleCode.ino, NixieClockShield314HW1.0.ino, NixieClockShieldNCS314AlternativeCustomversion.ino, NixieClockShieldNCS314HW1.1.ino, NixieClockShieldNCS314HW1.2.ino, NixieClockShield_NCS314.ino, NixieClockShield_NCS314_HW1.2_v.1.7b.ino, doIndication314_HW2.x.h]
2018-07-07 Remove all references to DHVpin since these are not neccesary since last update and can cause issues with leds randomly turn on
    [NixieClockShield_NCS314.ino]
2018-07-07 Change include arduino.h to Arduino.h to avoid 'No such file or directory' errors
    [doIndication314_HW2.x.h]
2018-07-12 Simple Code Sample added.
2018-07-12 Simple Code Sample added
2018-08-03 v. 1.83
    Fixed: Temp. reading speed fixed
    Fixed: Dots mixed up (driver was updated to v. 1.1)
    Fixed: RGB LEDs reading from EEPROM
    Fixed: Check for entering data from GPS in range
    [NixieClockShield_NCS314.ino, doIndication314_HW2.x.h, doIndication314_HW2.x.ino]
2018-08-03 arduino.h changed to Arduino.h
2019-07-26 60MinTimer
    Added firmware for 60 minutes countdown timer.
2019-08-23 v1.85
    Fixed: bug with time zones more than 9
    v1.84:
    LEDs functions moved to external file
    LEDs freezing while music (or sound) played.
    SPI Setup moved driver's file
    [NixieClockShield_NCS314.ino, doIndication314_HW2.x.h, doIndication314_HW2.x.ino, rotateFireWorks_RGB.ino]
2020-01-21 v1.85
    Fixed: Bug with time zones more than +-9
    [NixieClockShield_NCS314.ino]
2020-01-23 v.1.86
    New GPS sync algorithm
    // GPS parser has been replaced by NEOGPS library
    [NixieClockShield_NCS314.ino]
2020-07-09 v.1.90
    Fixed GPS Time Zone issue.
    Changes was made in "Time" library
    [NixieClockShield_NCS314.ino, NixieClockShield_NCS314_HW1.2_v.1.9.ino]
2021-01-28 v.1.91
    1. The driver has been changed to support BOTH HV5122 and HV5222 registers (switching using resistor R5222 Arduino pin No. 8)
    2. SPI initialization moved to function SPISetup()
2021-02-11 v.1.93
    Added/Fixed: press and hold DOWN button while powering on, will reverse upper and lower dots.
    [NixieClockShield_NCS314.ino, doIndication314_HW2.x.ino]
2021-05-04 CH340/341 Drivers Added
    CH340/341 Drivers Added
2022-01-14 v1.95
    GPS Anti Rollover Fix
    [NixieClockShield_NCS314.ino]
2023-02-27 Added schemes for 4 tubes shields
2023-04-06 v.1.96
    //Fixed: DS18b20 zeros bug
    [NixieClockShield_NCS314.ino]
2023-05-08 Update NCS314_v3_SimpleSample.ino
    Fixed a bug with tubes freezing
    [NCS314_v3_SimpleSample.ino]
2023-09-07 NightMode(Start)
    Просто добавил новое меню, которое управляется, но ни на что не влияет
2024-02-26 Drivers update
